DamianMorales1437/Automatizacion_y_Control/Diseño vru/Tabla Elementos.xlsx

LISTA DE MATERIALES INSTALADOS EN EL DOBLEFONDO Y GABINETE
ITEM | MARCA | REFERENCIA | DESCRIPCIÓN | CANT. | LINK
1 | ALLEN BRADLEY | 1769-L30ER | CONTROLADOR DUAL ETHERNET, MEMORIA 1Mb, EXPANDIBLE CON8 I/O, 16 NODOS ETHERNET IP | 1 | https://www.rockwellautomation.com/en-us/products/details.1769-L30ER.html
2 | ALLEN BRADLEY | 1769-PA2 | FUENTE DE ALIMENTACIÓN PARA COMPACT I/O A 120/240V CA, (5V @ 2 AMP) | 1 | https://www.rockwellautomation.com/en-us/products/details.1769-PA2.html
3 | ALLEN BRADLEY | 1769-IQ16 | MODULO DE ENTRADA DIGITAL DE16 CANALES 24VDC | 1 | https://www.rockwellautomation.com/en-us/products/details.1769-IQ16.html
4 | ALLEN BRADLEY | 1769-OB8 | MÓDULO DE SALIDA DIGITAL DE 8 CANALES 24V DC | 1 | https://www.rockwellautomation.com/en-us/products/details.1769-OB8.html
5 | ALLEN BRADLEY | 1769-IF16C | MÓDULO DE ENTRADA DE CORRIENTE ANALÓGICA DE ALTA DENSIDAD COMPACTA DE 16 CANALES | 1 | https://www.rockwellautomation.com/es-mx/products/details.1769-IF16C.html
6 | ALLEN BRADLEY | 1769-OF8C | MODULO DE SALIDAS DE CORRIENTE ANALOGICA DE ALTA TENSION COMPACTA DE 8 CANALES | 1 | https://www.rockwellautomation.com/es-mx/products/details.1769-OF8C.html
7 | ALLEN BRADLEY | 1769-ECR | TERMINADOR FINAL DERECHO PARA COMPACTLOGIX | 1 | https://www.rockwellautomation.com/en-us/products/details.1769-ECR.html
8 | ALLEN BRADLEY | 1606-XLE240E | FUENTE DE ALIMENTACIÓN 24-28V DC, 240 W, 120/240V AC | 1 | https://www.rockwellautomation.com/en-us/products/details.1606-XLE240E.html
9 | ALLEN BRADLEY | 4983-DS120-402 | 4983 SURGE AND FILTER PROTECTION 120V, 40kA | 1 | https://www.rockwellautomation.com/en-us/products/details.4983-DS120-402.html
10 | SCHNEIDER ELECTRIC | A9F74210 | INTERRUPTOR BIPOLAR DE 10A | 1 | https://www.se.com/co/es/download/document/A9F74210_REACH_DECLARATION/
11 | STEGO | 01220.0-00 | HIGRÓSTATO MECÁNICO MFR012, (CAMPO DE REGULACIÓN DE 35 A 95%) MECHANICAL HYGROSTAT MFR 012 | 1 | https://www.directindustry.es/prod/stego/product-14212-186929.html
12 | STEGO | 01140.0-00 | TERMOSTATO SERIE 011, 0°C TO +60°C, NORMALMENTE CERRADO 10 A at 250 VAC | 1 | https://es.farnell.com/stego/01140-0-00/termostato-0-60-c-n-c/dp/645849
13 | STEGO | 02540.3-11 | LÁMPARA DE ILUMINACIÓN TIPO LED PARA INSTALAR EN TECHO DEL GABINETE | 1 | https://es.farnell.com/stego/02540-3-11/enclosure-light-5w-240v-screw/dp/3223082?st=02540.3-11
14 | STEGO | 06000-0.00 | RESISTENCIA CALEFACTORA 240V, 60W, 184mm, 70mm, 60mm | 1 | https://es.farnell.com/stego/06000-0-00/calentador-120-240v-ac-dc-50w/dp/1870826?st=06000-0.00
15 | DEXSON | DXN10092 | CANALETA RANURADA DE 60x60mm (ANCHO x ALTO) | - | https://www.se.com/co/es/download/document/DXN10092_ROHS_DECLARATION/
16 | DEXSON | DXN10072 | CANALETA RANURADA DE 40x60mm (ANCHO x ALTO) | - | https://www.se.com/co/es/download/document/DXN10072_ROHS_DECLARATION/
17 | FANDIS | FC-003 | INTERRUPTOR PARA LÁMPARA INSTALADO EN PUERTA (-1NC + 1NO) | 1 | https://www.fandis.com/en/products/FC-003/Limit-switch-with-roller-
18 | ALLEN BRADLEY | 1492-J6 | BORNA DE PASO ESTANDAR (ENTRADA ACOMETIDA) | 4 | https://www.rockwellautomation.com/en-us/products/details.1492-J6-BL.html
19 | ALLEN BRADLEY | 1492-JG6 | BORNA DE TIERRA (ENTRADA ACOMETIDA) | 2 | https://www.rockwellautomation.com/en-us/products/details.1492-JG6.html
20 | SCHNEIDER ELECTRIC | A9F74216 | INTERRUPTOR BIPOLAR DE 16A | 1 | https://www.se.com/co/es/download/document/A9F74216_REACH_DECLARATION/
21 | ALLEN BRADLEY | 1492-JD3FB24 | BORNA DE 2 NIVELES (BORNA PORTAFUSIBLE + BORNA DE PASO) | 48 | https://www.rockwellautomation.com/en-us/products/details.1492-JD3FB24.html
22 | ALLEN BRADLEY | 1492-JDG3FB | BORNA DE 3 NIVELES (BORNA PORTAFUSIBLE + BORNA DE PASO + BORNA DE TIERRA) | 3 | https://www.rockwellautomation.com/en-us/products/details.1492-JDG3FB.html
23 | ALLEN BRADLEY | 1492-GM35 | PORTAROTULO MARCADOR DE GRUPO | 11 | https://www.rockwellautomation.com/en-us/products/details.1492-GM35.html
24 | ALLEN BRADLEY | 1492-ERL35 | FRENO PARA BORNAS Y COMPONENTES | 35 | https://www.rockwellautomation.com/en-us/products/details.1492-ERL35.html
25 | ALLEN BRADLEY | 1492-WFB424 | BORNA PORTAFUSIBLE CON LED DE FALLA | 4 | https://www.rockwellautomation.com/en-us/products/details.1492-WFB424.html
26 | ALLEN BRADLEY | 1492-WFB4250 | BORNA PORTAFUSIBLE CON NEÓN DE FALLA | 5 | https://www.rockwellautomation.com/en-us/products/details.1492-WFB4250.html
27 | ALLEN BRADLEY | 1492-J4 | BORNA DE PASDO ESTANDAR | 9 | https://www.rockwellautomation.com/en-us/products/details.1492-J4.html
28 | ALLEN BRADLEY | 1492-EBJD3FB | TAPA PARA BORNAS DE 2 NIVELES Y 3 NIVELES | 2 | https://www.rockwellautomation.com/en-us/products/details.1492-EBJD3FB.html
29 | ALLEN BRADLEY | 1492-EBJ3 | TAPA PARA BORNAS DE PASO ESTANDAR | 6 | https://www.rockwellautomation.com/en-us/products/details.1492-EBJ3.html
30 | MATRIMOL | T-25M | AISLADOR PARA BARRAS DE TIERRA Y RIELES DIN OMEGA | 15 | https://matrimol.com.co/producto/t-25m/
31 | N/A | N/A | BARRAS DE TIERRA | 2
32 | ALLEN BRADLEY | 199-DR2 | RIEL DIN OMEGA 35mm | 5 | https://www.rockwellautomation.com/en-us/products/details.199-DR2.html
33 | NACIONAL | N/A | POLICARBONATO TRANSPARENTE DE 3 mm DE ESPESOR | 2
33 |  |  |  | 1
34 |  |  |  | 1
