DamianMorales1437/Automatizacion_y_Control/(list of files, cad)

Other CAD files:
Diseño vru/Conexionado/5005.dwg
Diseño vru/Planos DWG/DI2.dwg
Diseño vru/PLCsv2.dwg
Diseño vru/Conexionado/5015.dwg
Diseño vru/Planos DWG/AI1.dwg
Diseño vru/Conexionado/5013.dwg
Diseño vru/Planos DWG/Tablero.dwg
Diseño vru/Conexionado/5010.dwg
Diseño vru/Planos DWG/DI1.dwg
Diseño vru/Conexionado/5014.dwg
Diseño vru/Planos DWG/TBDC_5005.dwg
Diseño vru/Conexionado/5007.dwg
Diseño vru/Planos DWG/AO.dwg
Diseño vru/Conexionado/5008.dwg
Diseño vru/Planos DWG/Alimentacion120VAC_5004.dwg
Diseño vru/Conexionado/5012.dwg
Diseño vru/Planos DWG/DO.dwg
Diseño vru/Conexionado/5006.dwg
Diseño vru/Planos DWG/Alimentación230VAC_5003.dwg
Diseño vru/Conexionado/5016.dwg
Diseño vru/Planos DWG/AI2.dwg
Diseño vru/Conexionado/5004.dwg
Diseño vru/Conexionado/5003.dwg
Diseño vru/Conexionado/5011.dwg
Diseño vru/Conexionado/5017.dwg
Diseño vru/Conexionado/5009.dwg
