DamianMorales1437/Automatizacion_y_Control/Diseño vru/wiringdetail.xlsx

TB-1 Discrete In | Instrument Tag | Termination Point | Notes
DI #00 | LS-0108 | D-0101 Gas suction scrubber pressure switch high | 0-24 vdc signals
DI #01 | LC-0109 | D-0101 Gas suction scrubber pressure switch low | 0-24 vdc signals
DI #02 | XS-0102 | LTP-0102 run status signal | 0-24 vdc signals | conexión | ps | plc | di | do | ai
DI #03 | XA-0102 | LTP-0102 overload alarm | 0-24 vdc signals | referencia | 1606-XLE240E | 1769-L30ER | 1769-IQ16 | 1769-OB8 | 1769-IF4
DI #04 | XS-0104 | E-0104 cooler fan status signal | 0-24 vdc signals
DI #05 | XA-0104 | E-0104 cooler fan overload alarm | 0-24 vdc signals
DI #06 | XS-0103 | K-0103 gas compressor run status signal | 0-24 vdc signals
DI #07 | XA-0103 | K-0103 gas compressor overload alarm | 0-24 vdc signals
DI #08 | XST-0103 | k-0103 gas compressor fail to start | 0-24 vdc signals
DI #09 | XSP-0103 | k-0103 gas compressor fail to stop | 0-24 vdc signals
DI #10 | spare
DI #11 | spare
DI #12 | spare
DI #13 | spare
DI #14 | spare
DI #15 | spare
DI #16
TB-2 Discrete Out | Instrument Tag | Termination Point | Notes
DO #00 | LY-0109 | LTP motor start/stop signal | salida del plc que enciende bomba
DO #01 | XY-0122 | cooler fan motor start/stop signal | salida del plc que enciende fan
DO #02 | XY-0115 | gas compressor motor start/stop signal | salida del plc para VSD encienda motor
DO #03 | XY-0102 | solenoid valve open/close signal | salida del plc para activar valvula de control
TB-3 Analog In | Instrument Tag | Termination Point | Notes
AI #00 | PT-0107 | D-0101 Gas suction scrubber pressure transmitter | 4-20 mA signals
AI #01 | PT-0105 | Gas compressor discharge pressure | 4-20 mA signals
AI #02 | TT-0103 | Gas compressor discharge temperature | 4-20 mA signals
DO #03 | XY-0102 | solenoid valve open/close signal | salida del plc para activar valvula de control
DO #04
DO #05
DO #06
DO #07
DO #08
DO #09
DO #10
DO #11
DO #12
DO #13
DO #14
DO #15
TB-3 Analog In | Instrument Tag | Termination Point | Notes
AI #00 | PT-0107 | D-0101 Gas suction scrubber pressure transmitter | 4-20 mA signals
AI #01 | PT-0105 | Gas compressor discharge pressure | 4-20 mA signals
AI #02 | TT-0103 | Gas compressor discharge temperature | 4-20 mA signals
AI #03
AI #04
AI #05
AI #06
AI #07
AI #08
AI #09
AI #10
AI #11
AI #12
AI #13
AI #14
AI #15
