DamianMorales1437/Automatizacion_y_Control/Diseño vru/2180389 _L1A.pdf

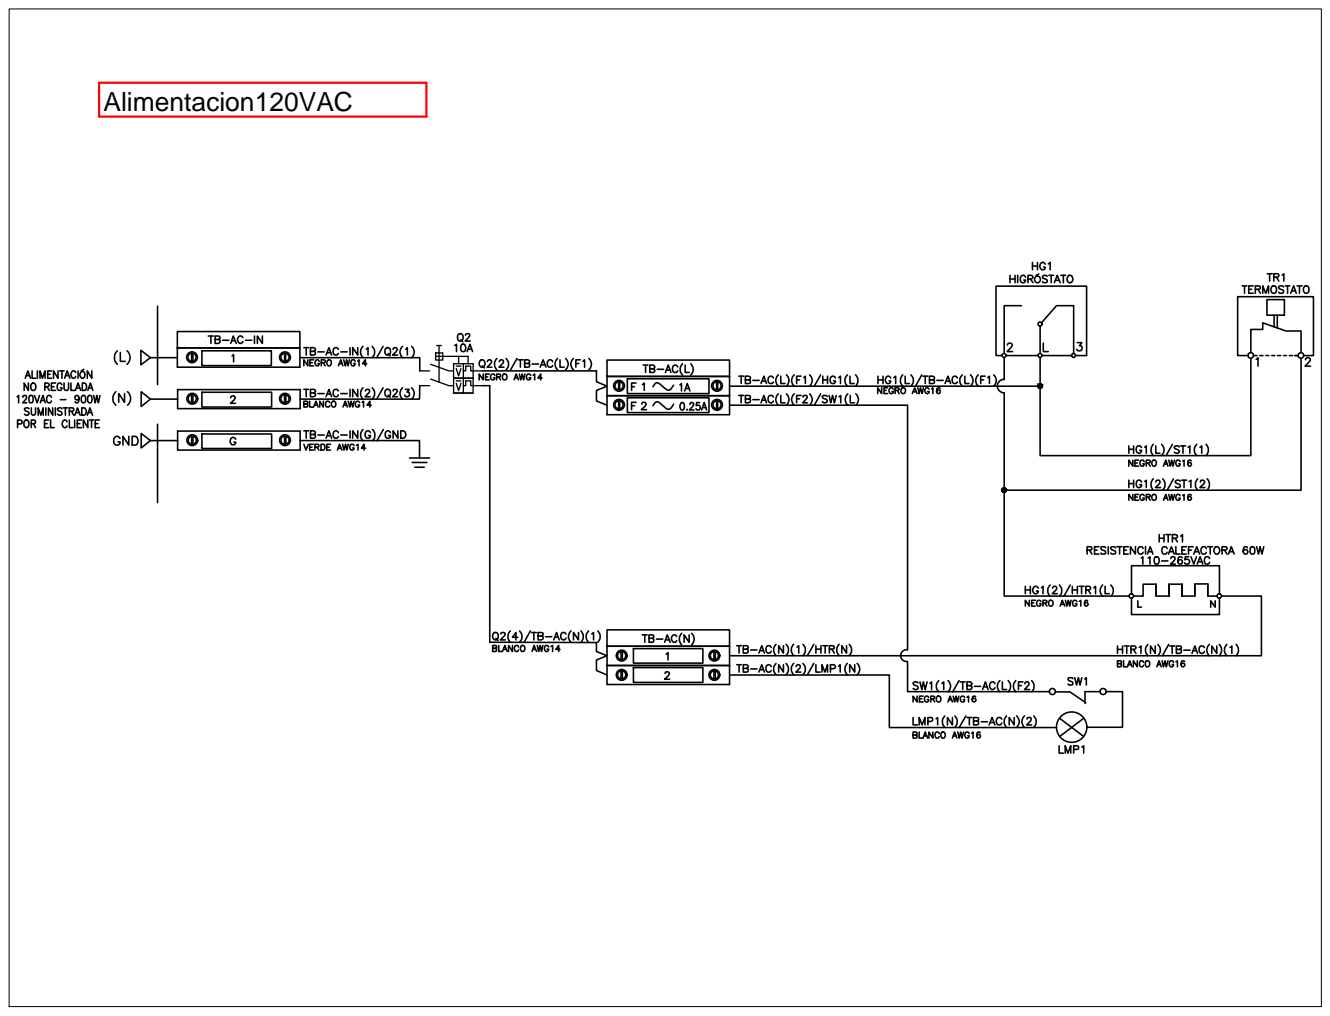
[picture p4: page 5]
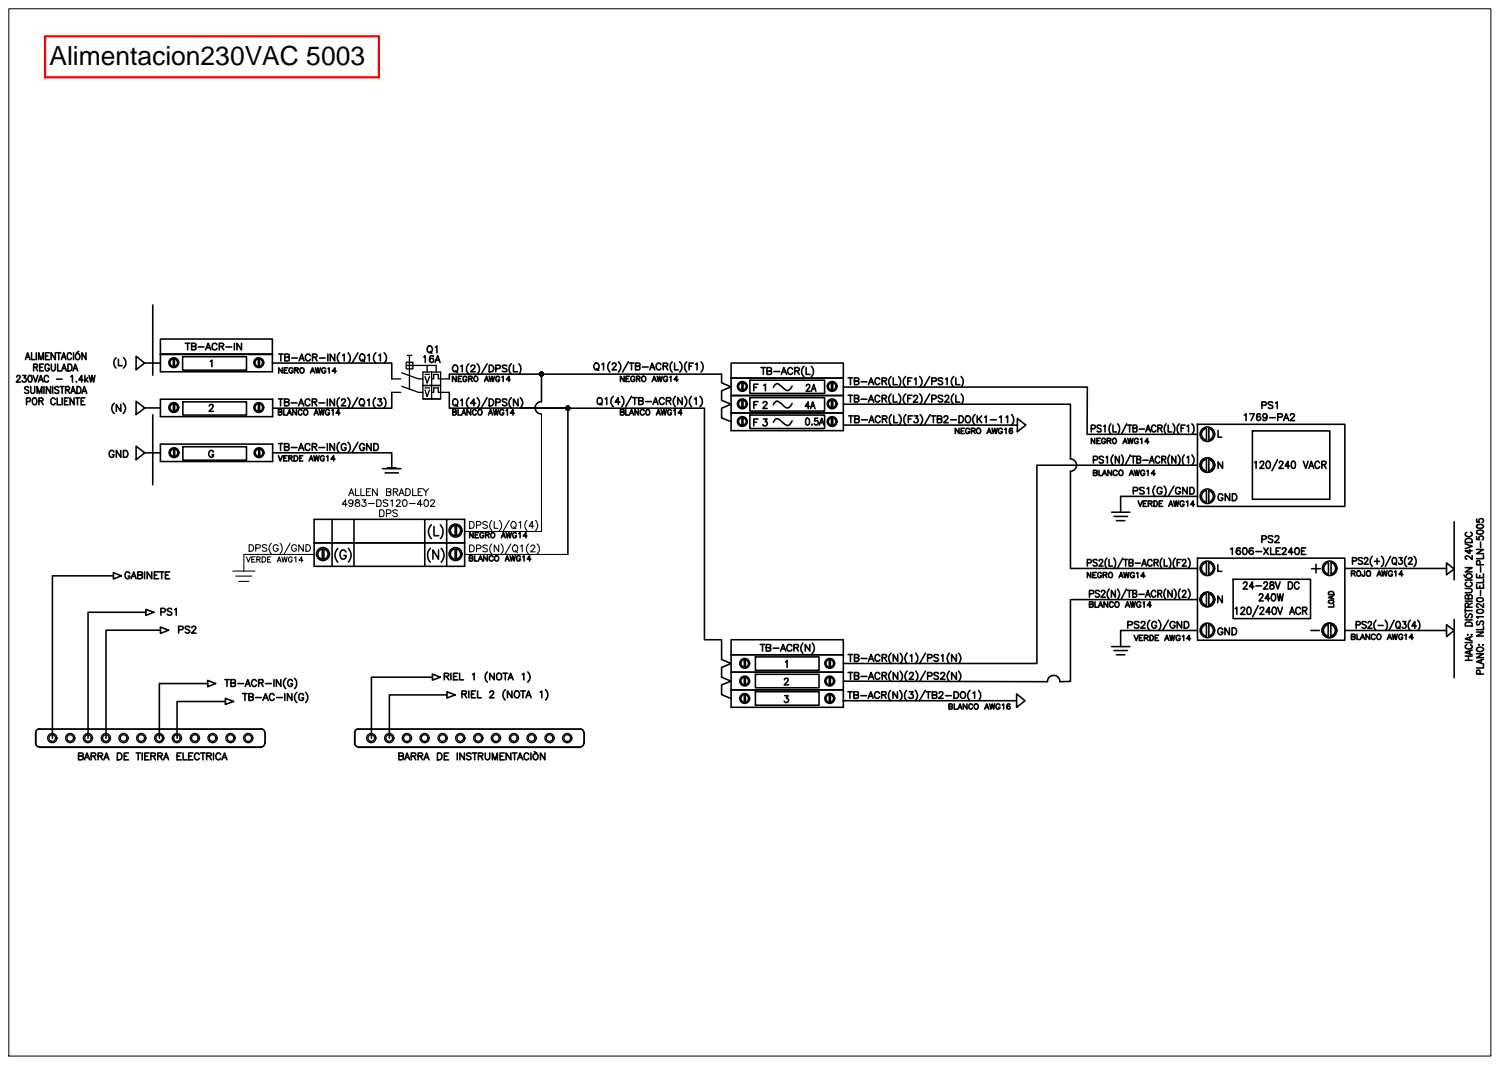
[picture p5: page 6]
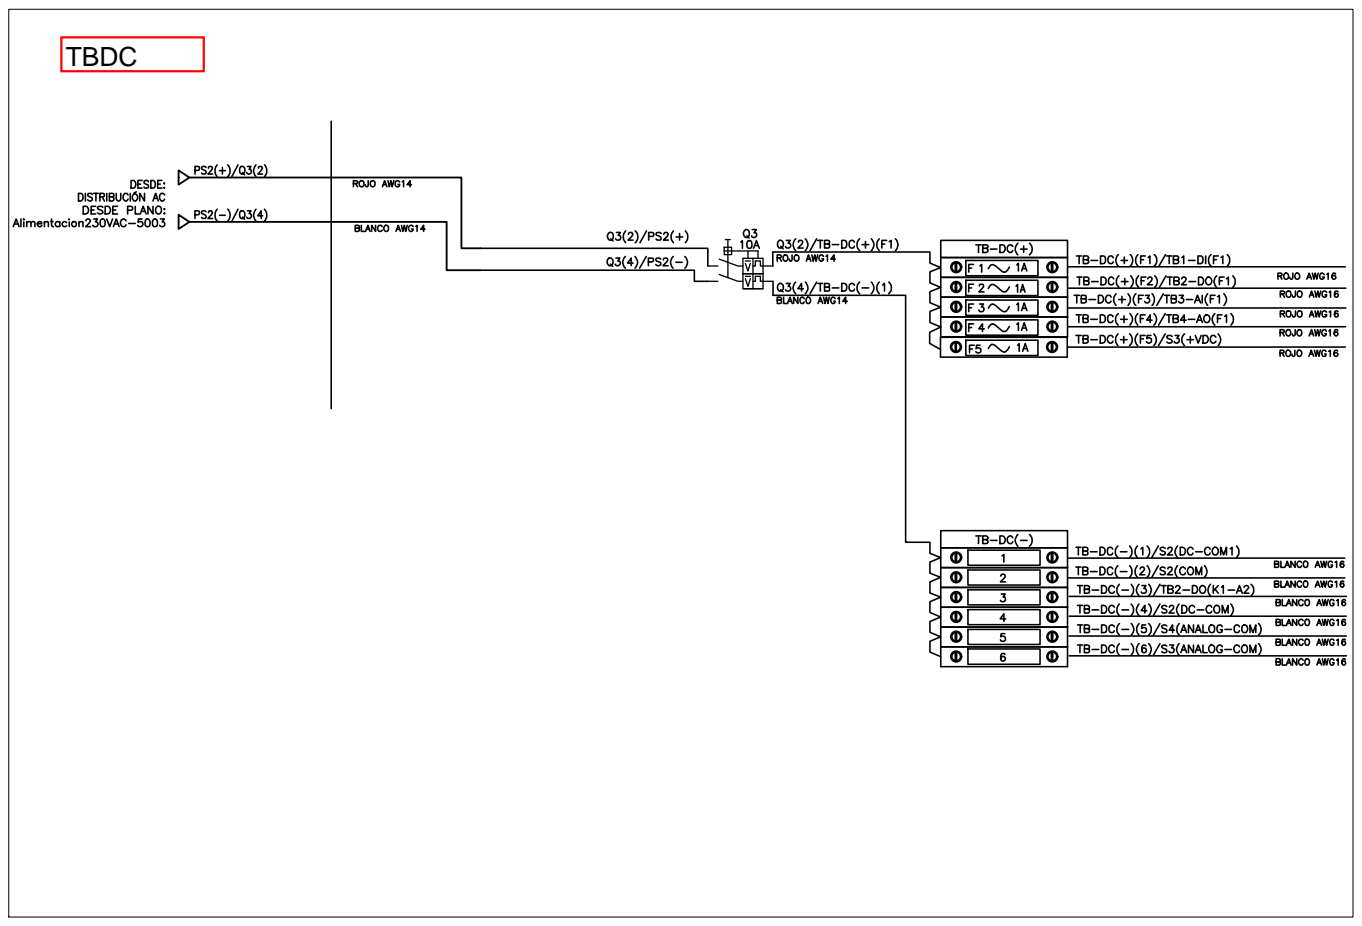
[picture p6: page 7]
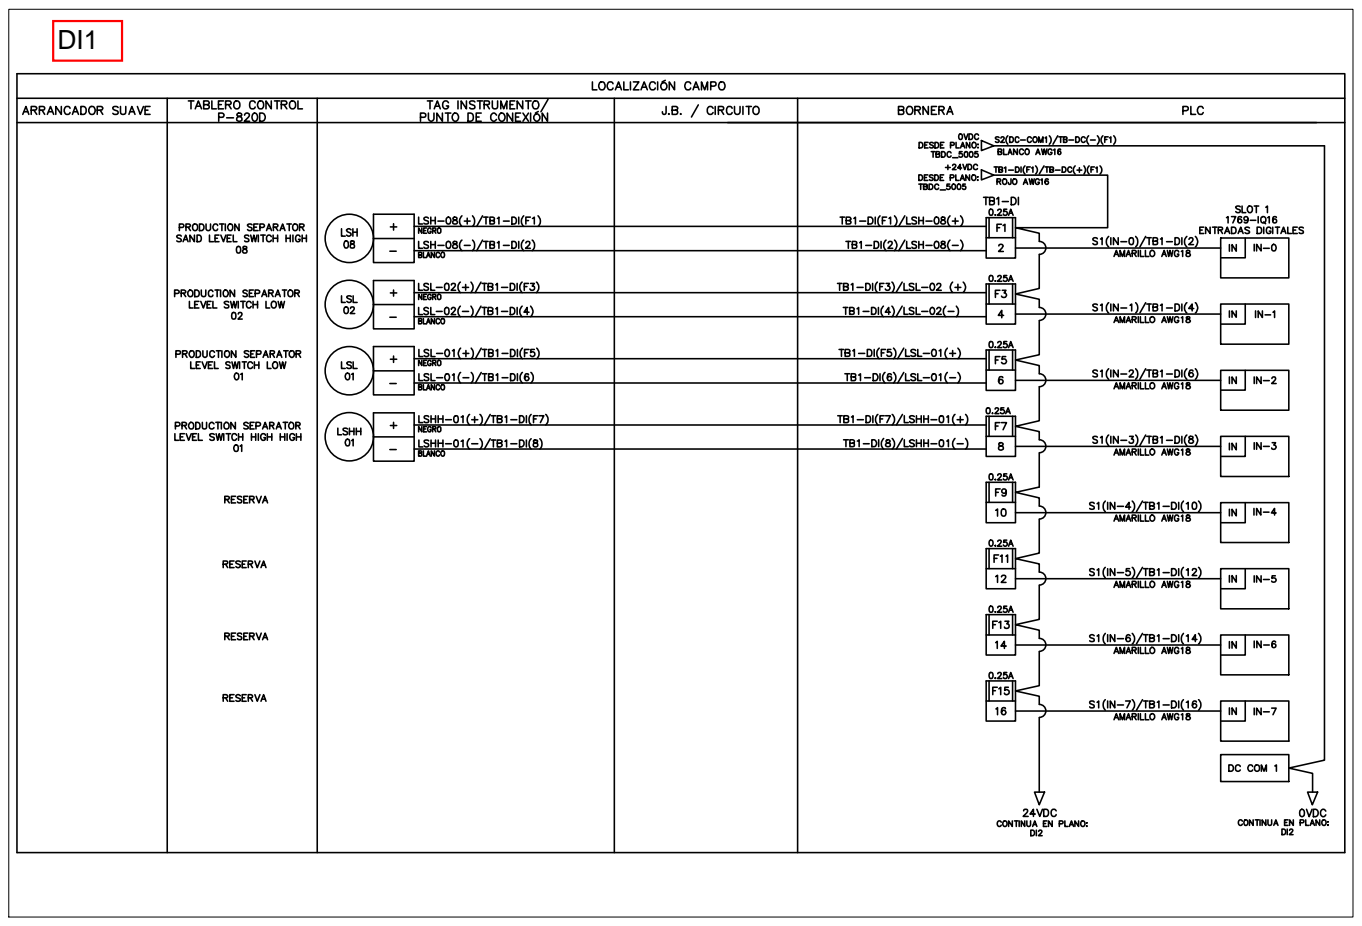
[picture p7: page 8]
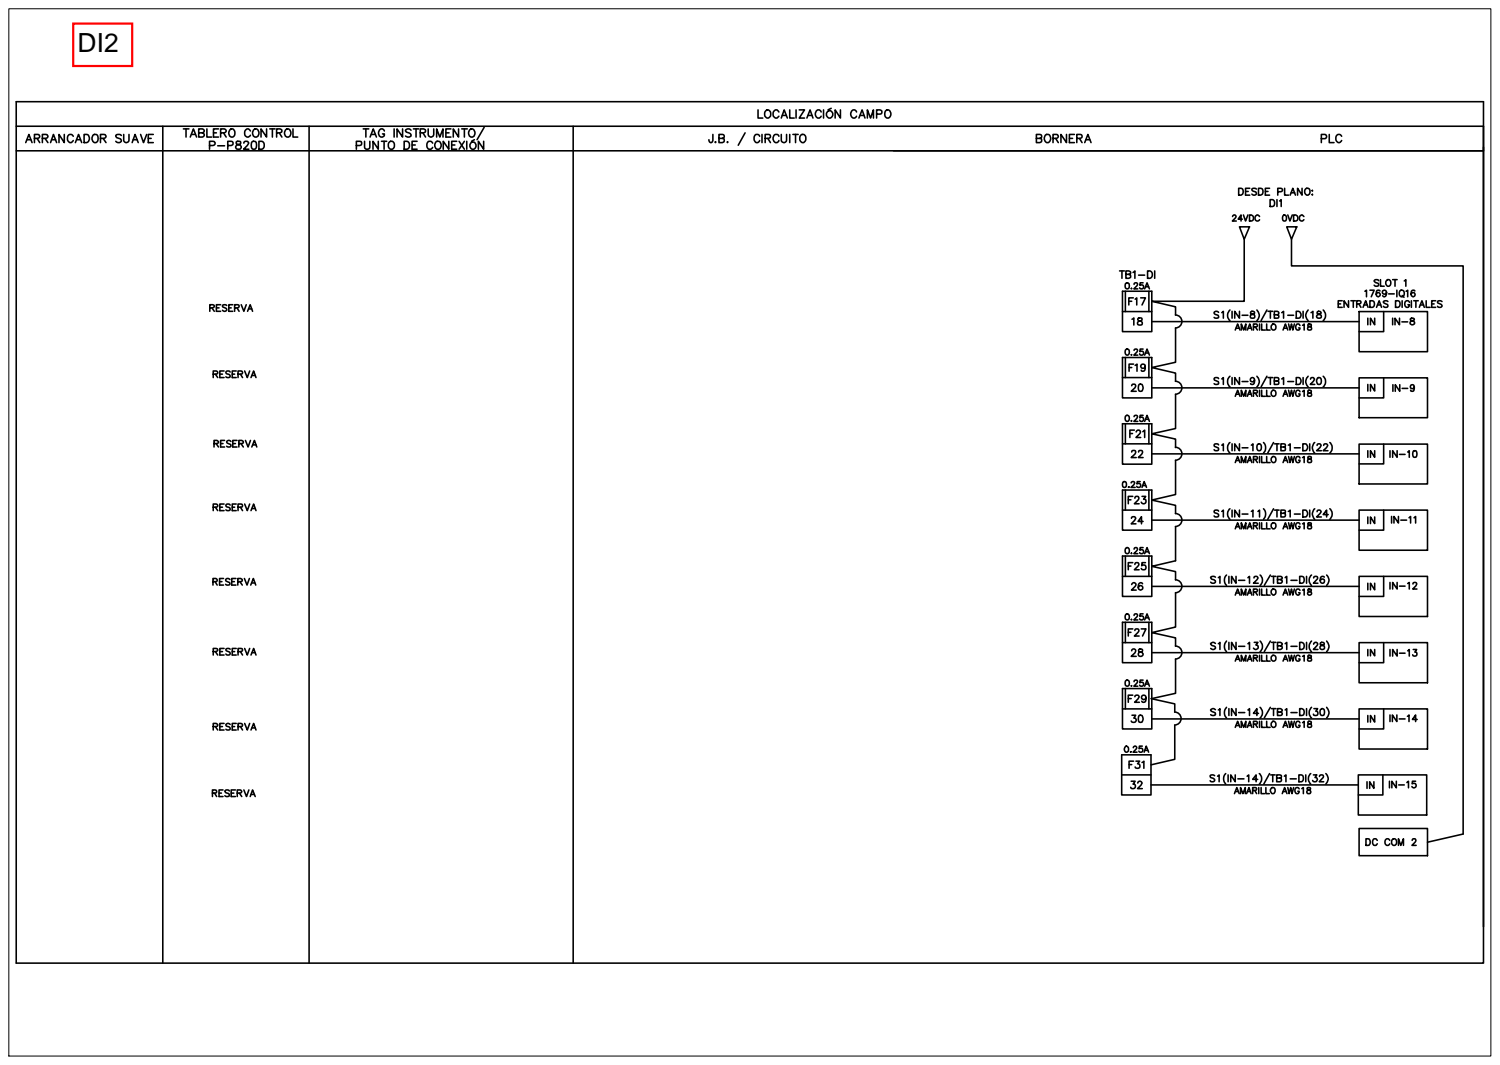
[picture p8: page 9]
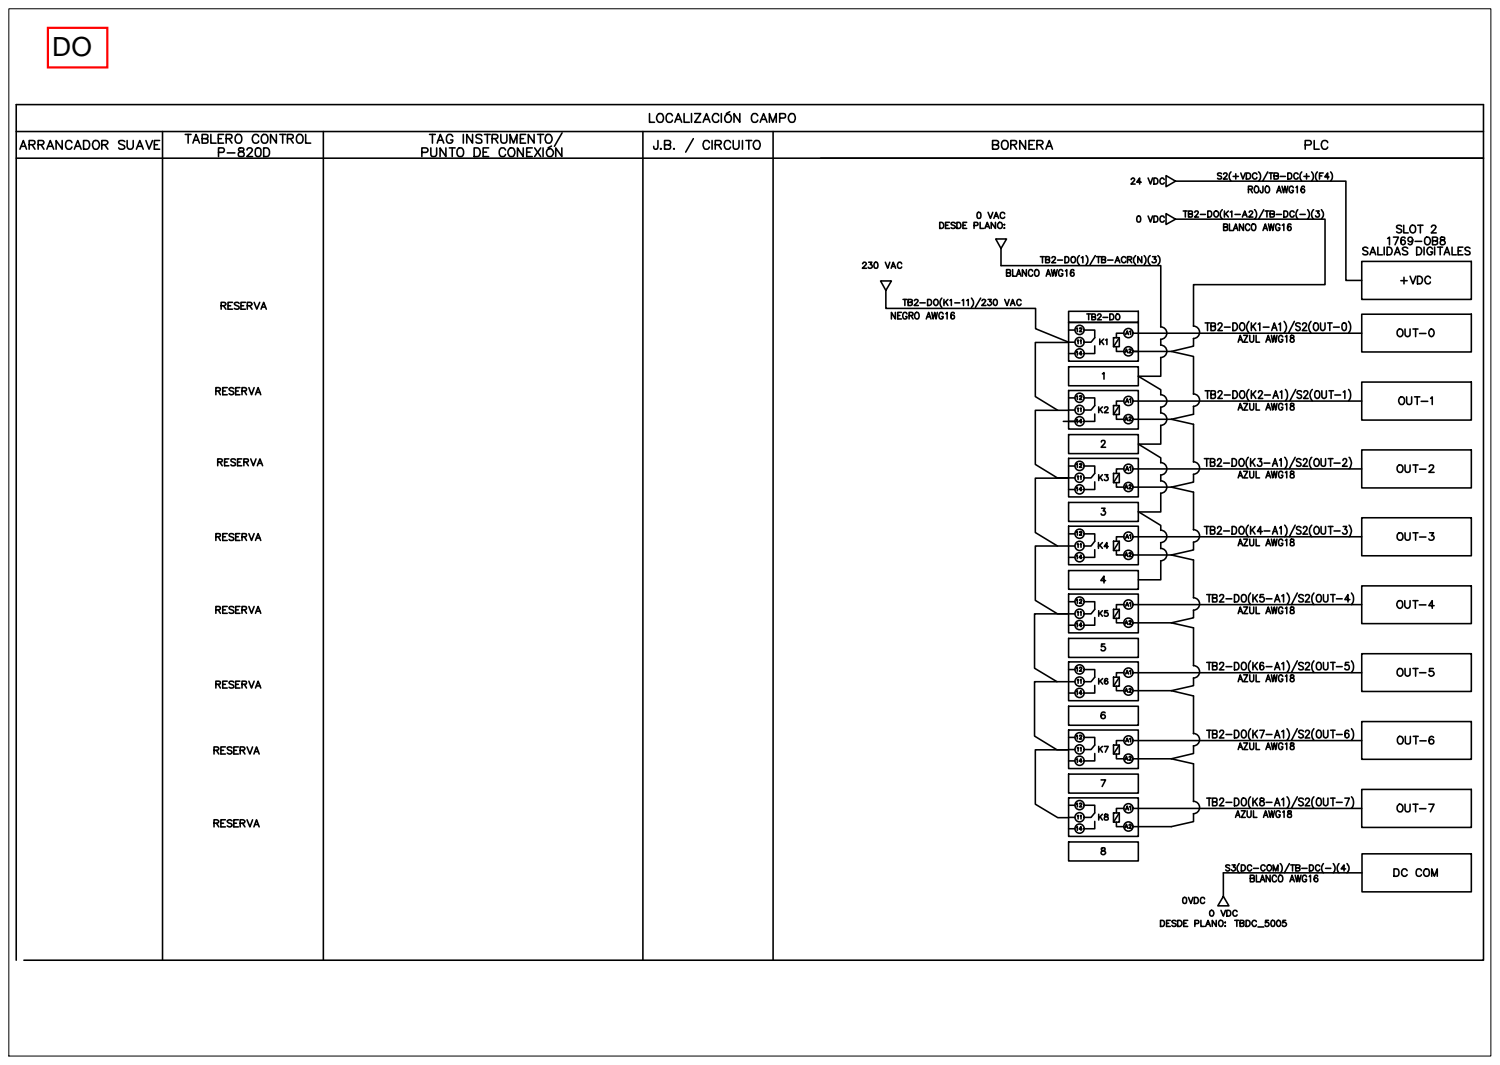
[picture p9: page 10]
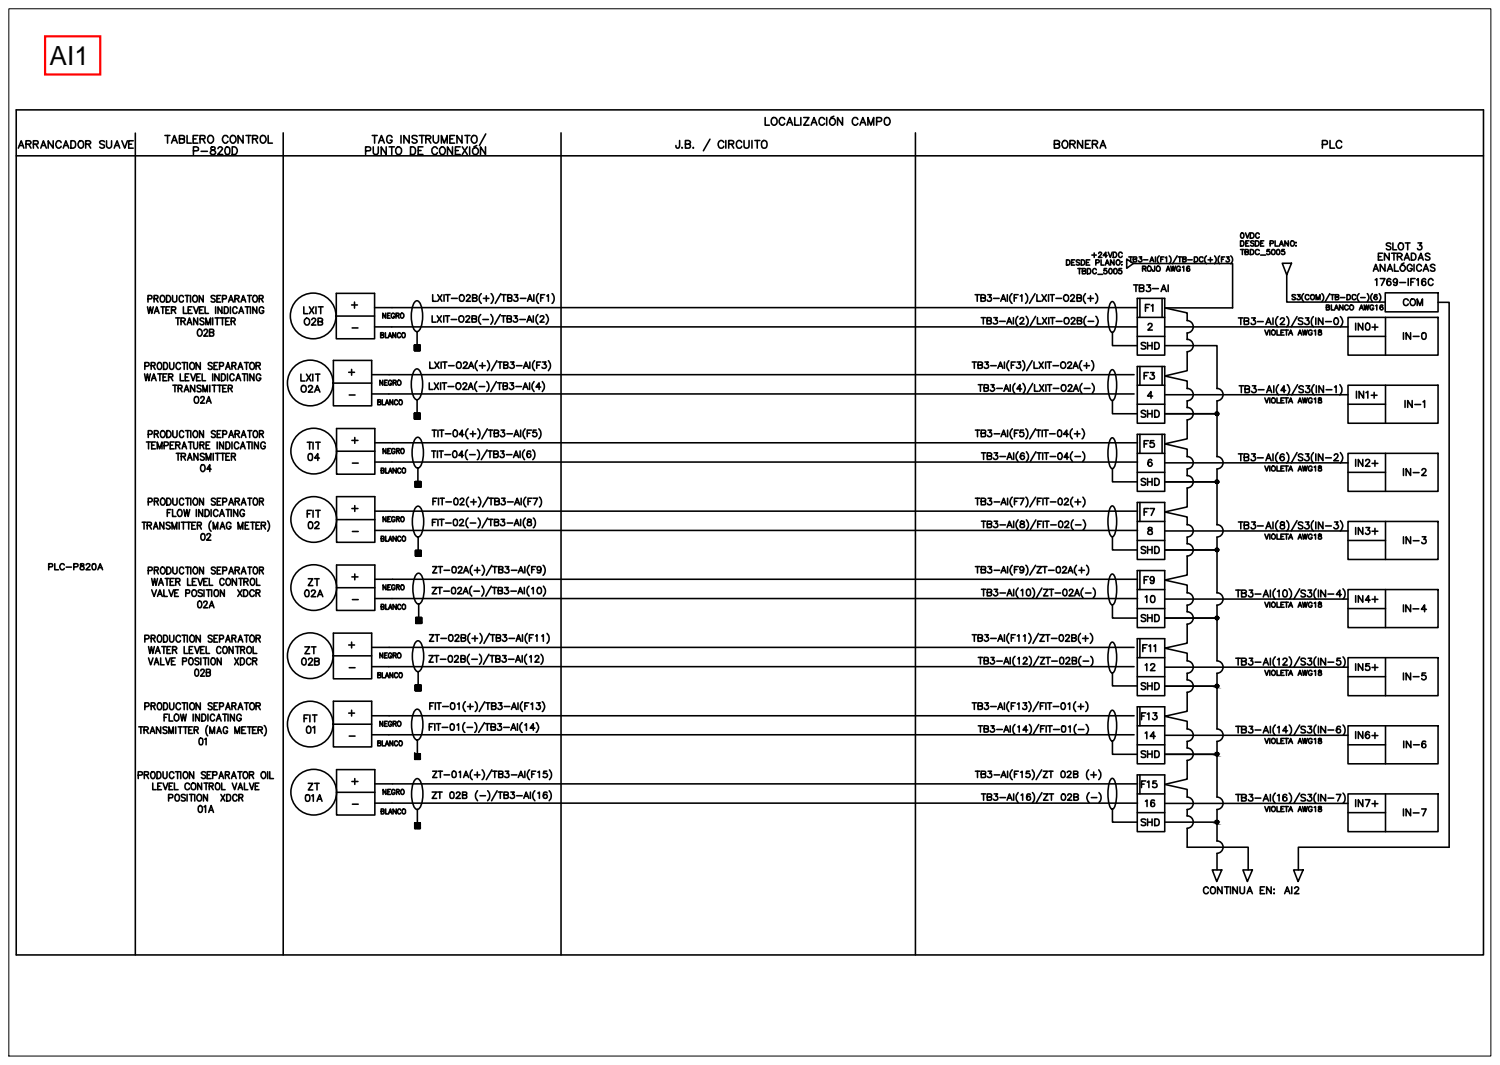
[picture p10: page 11]
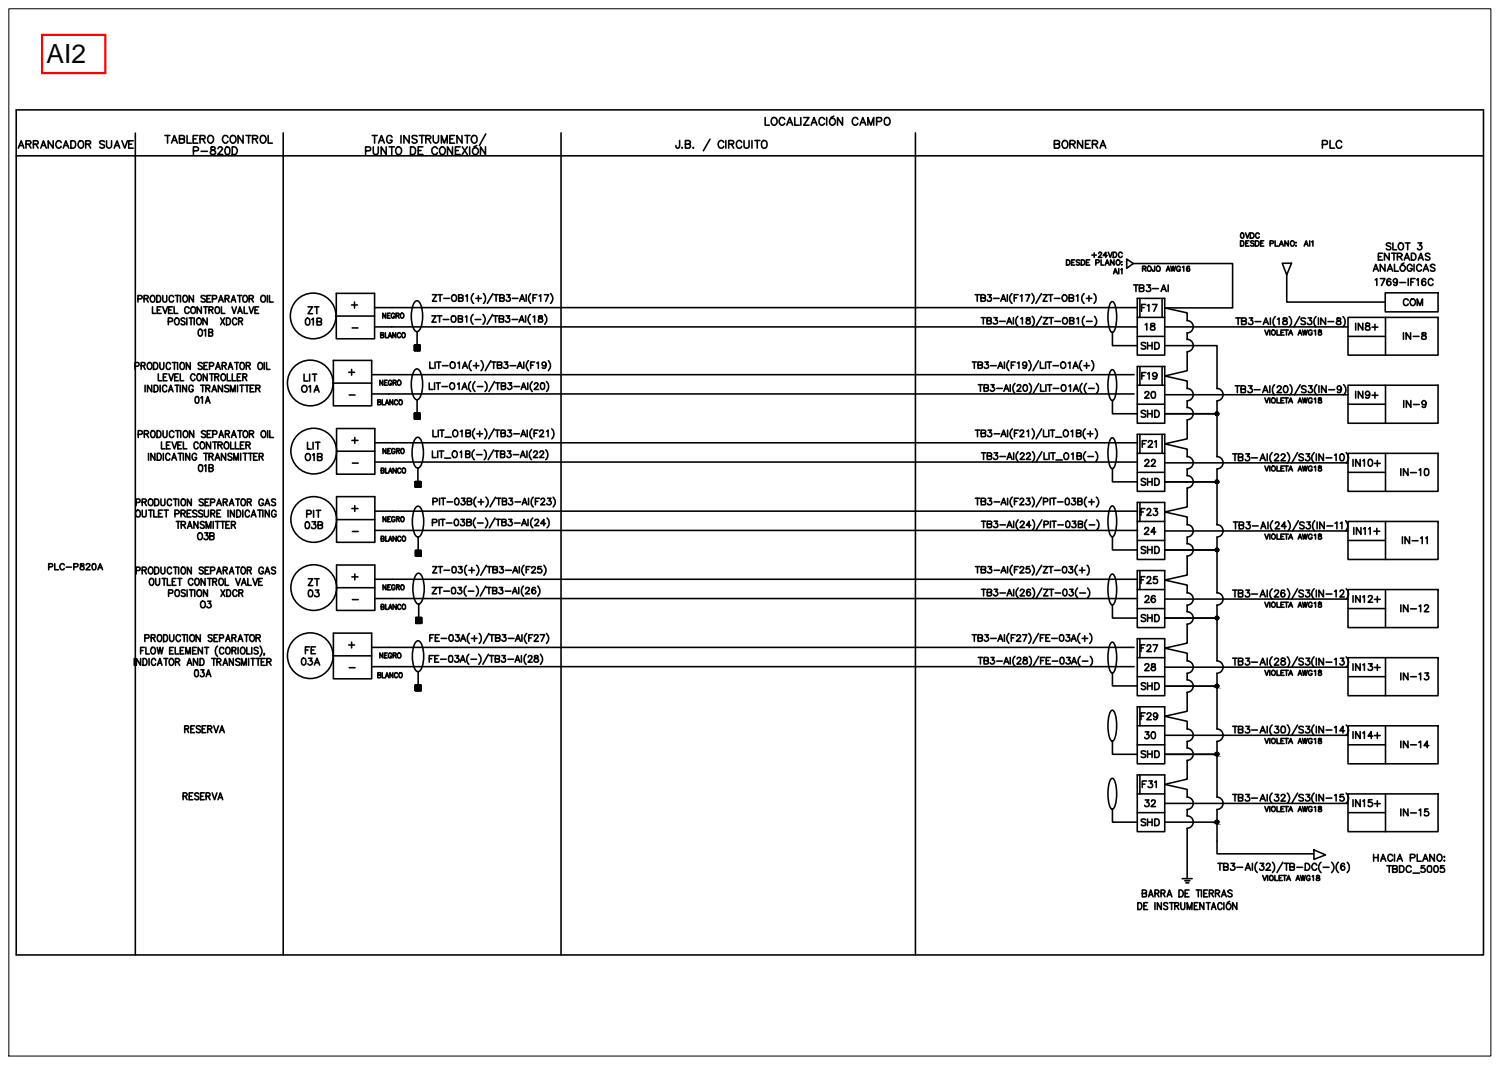
[picture p11: page 12]
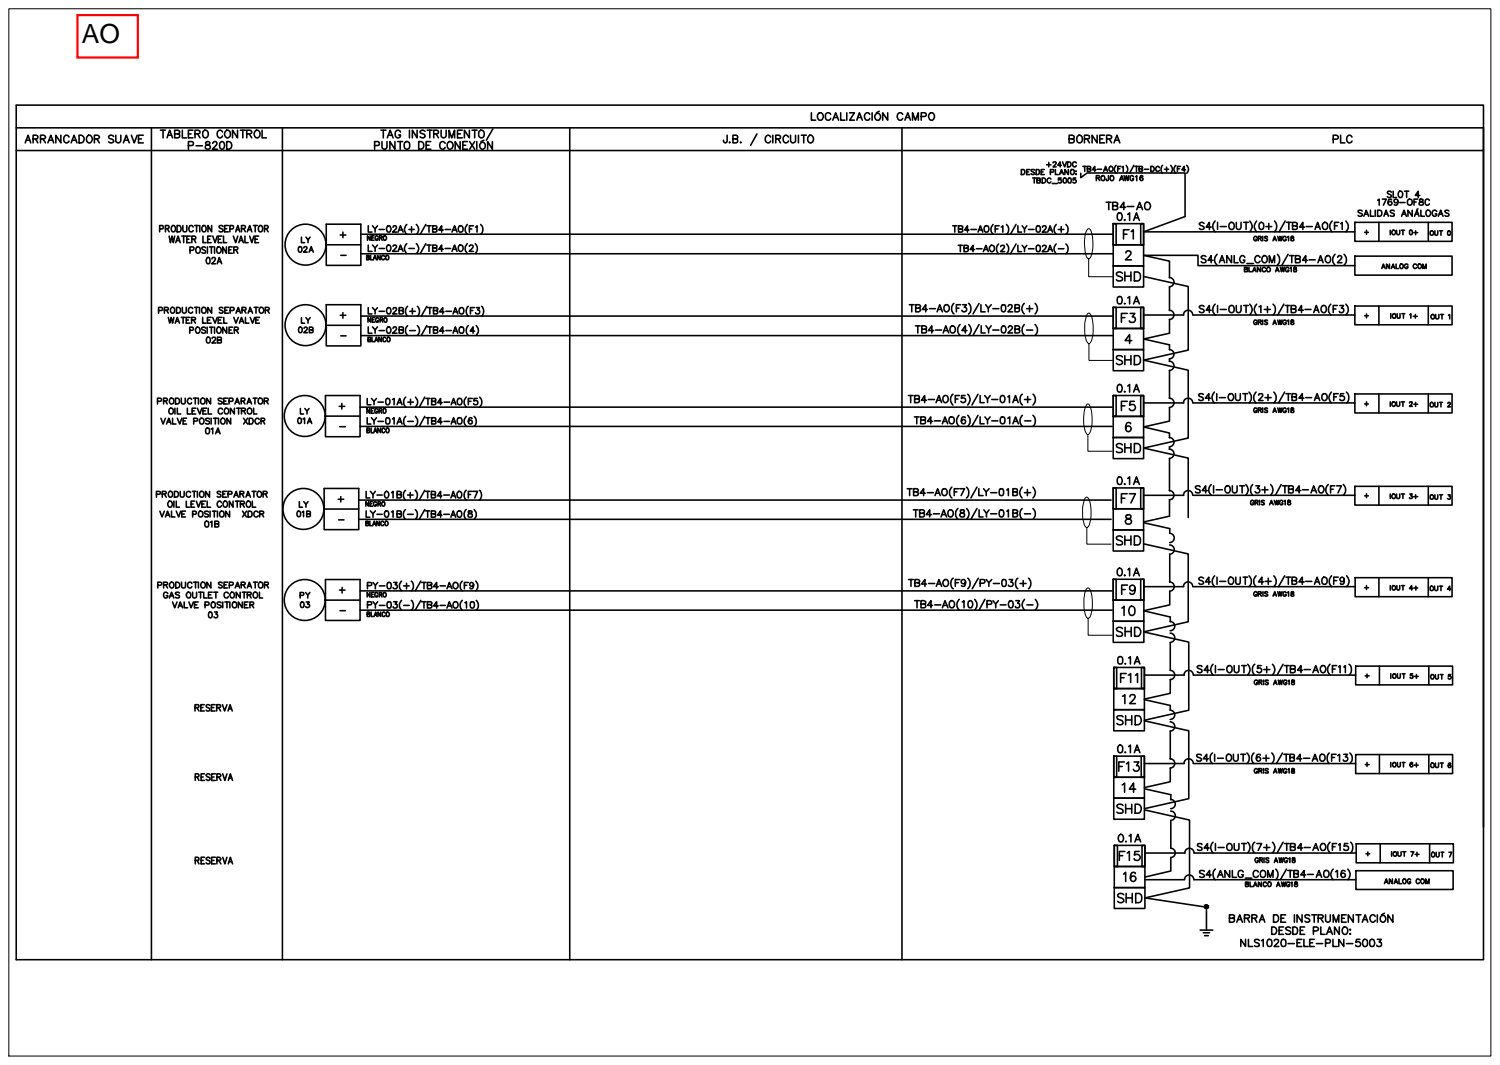
[picture p12: page 13]
