DamianMorales1437/Automatizacion_y_Control/Diseño vru/RIOTYPEB (1).pdf

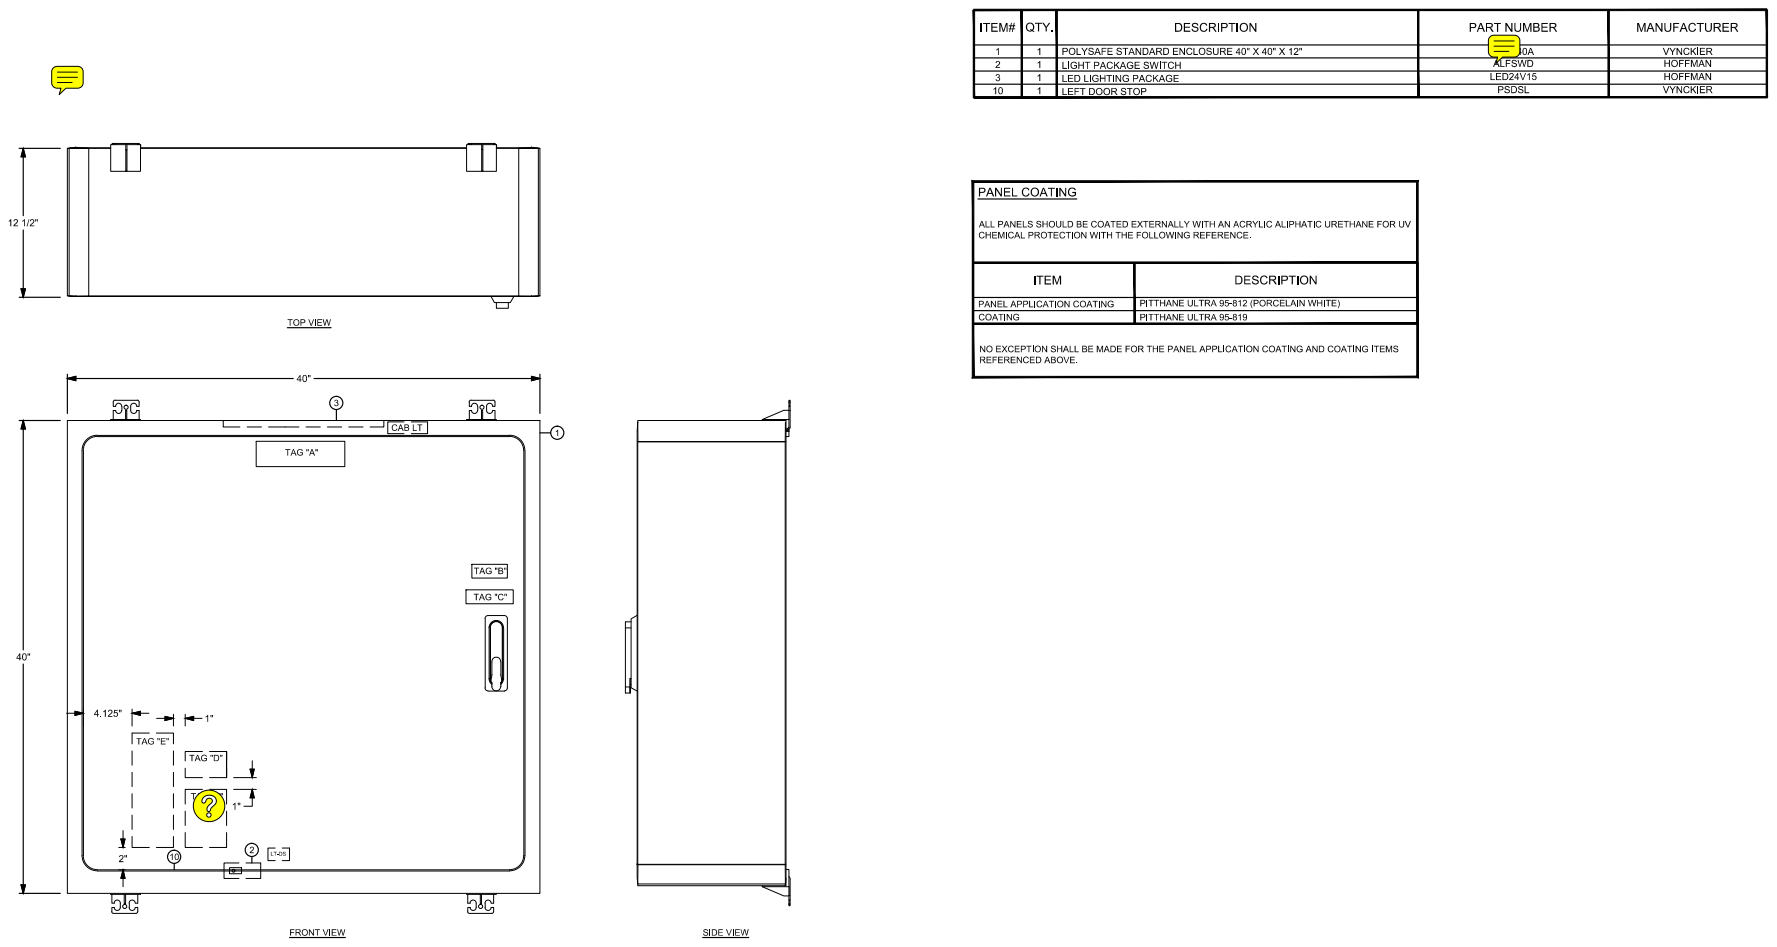
[picture p13: page 1]
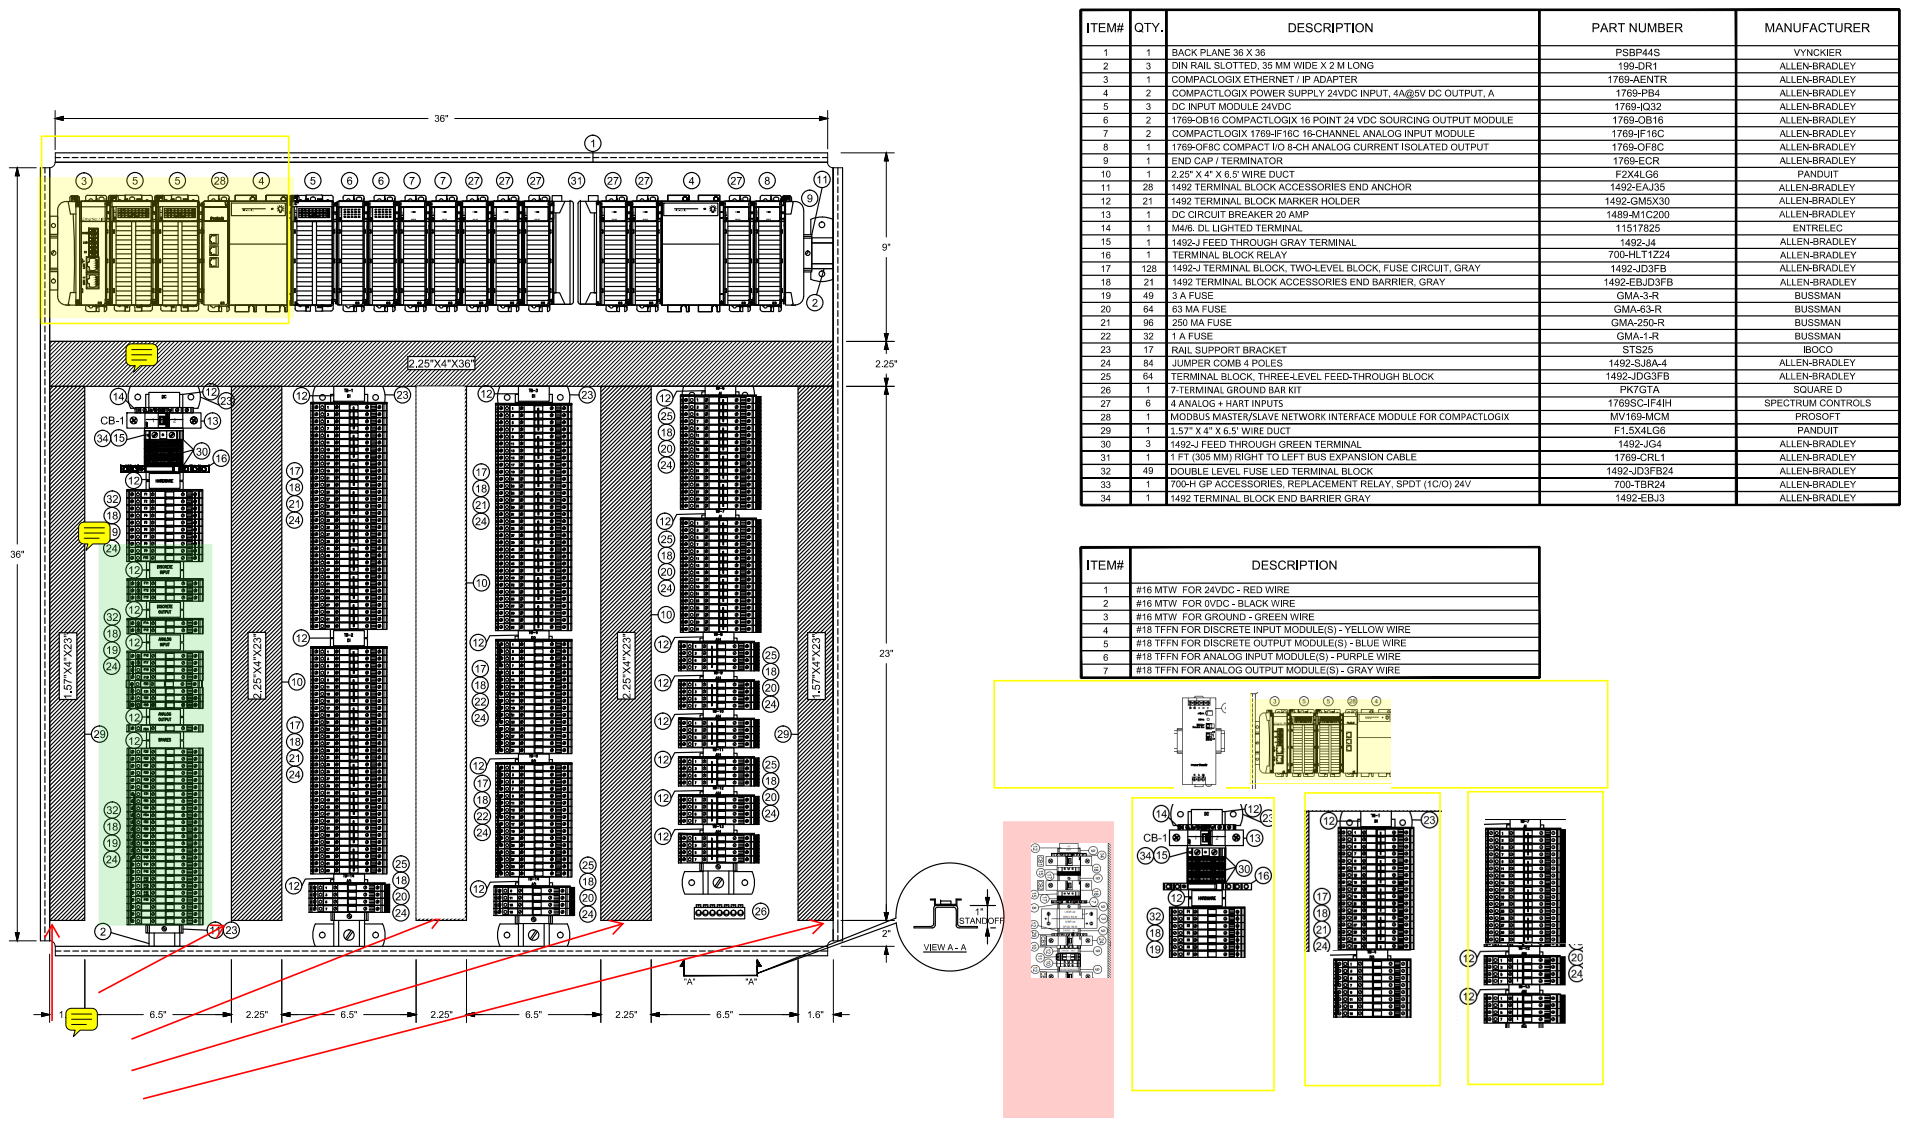
[picture p14: page 2]
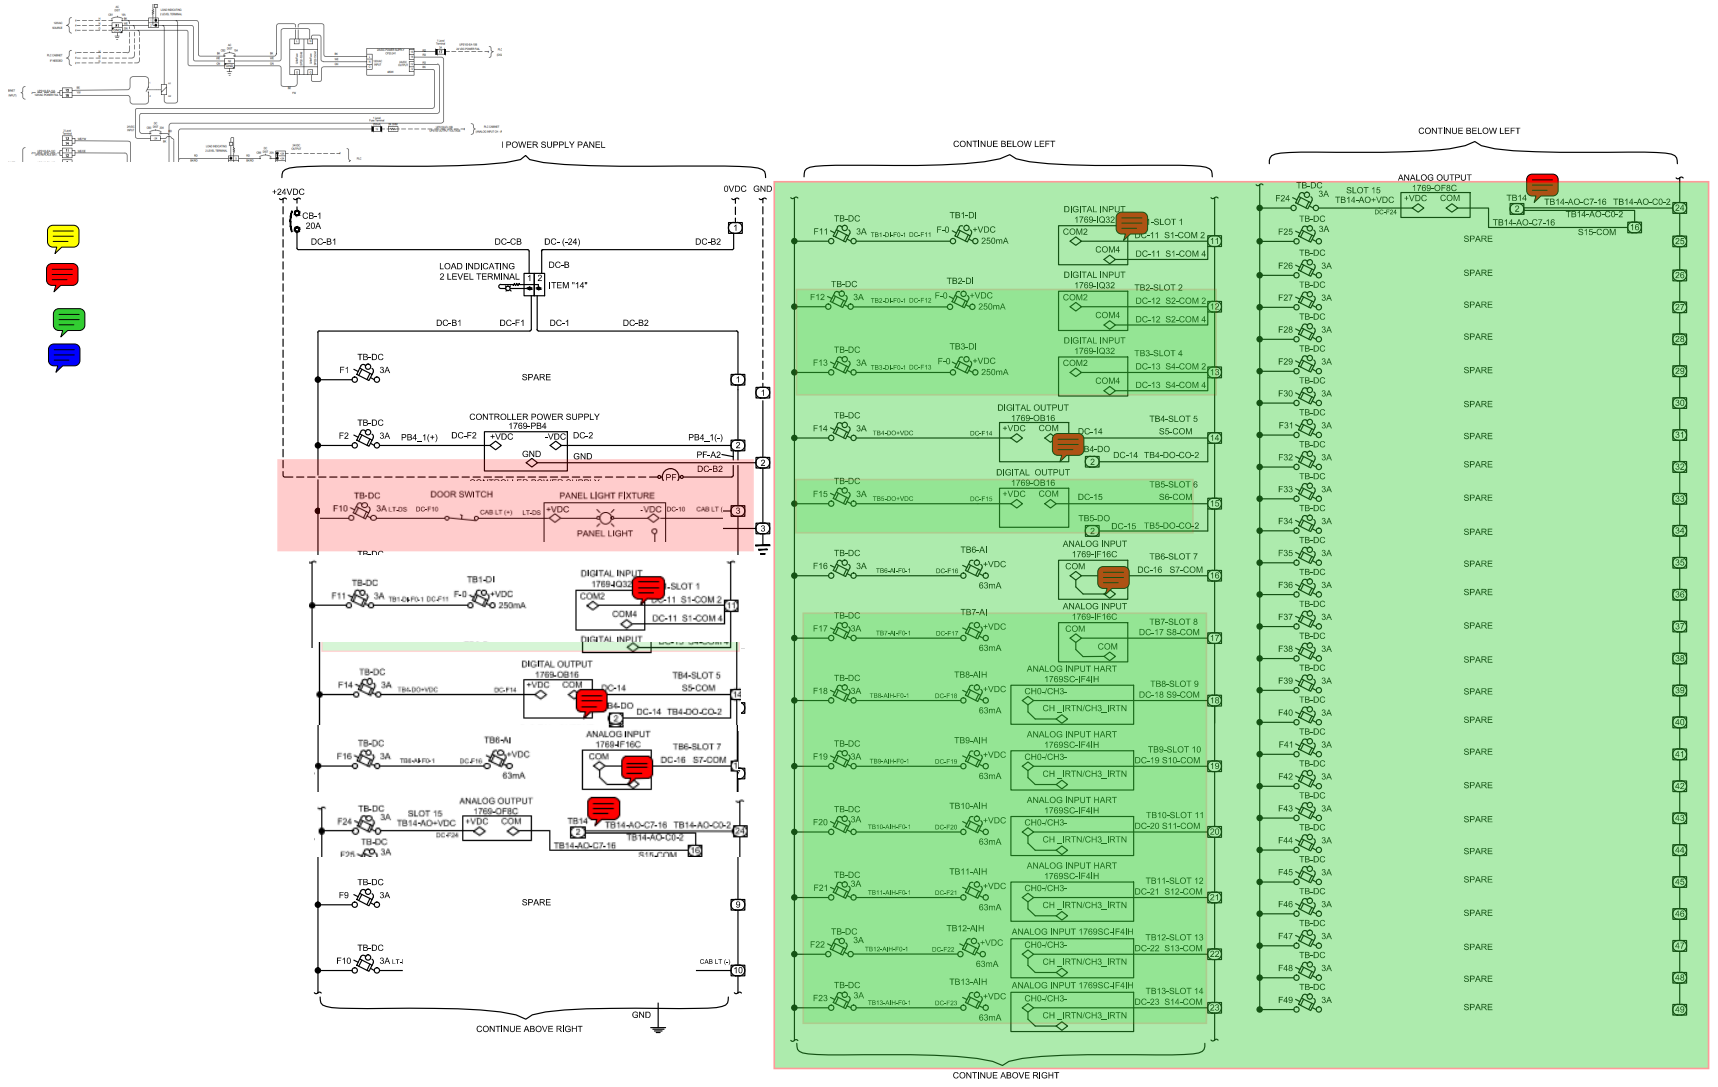
[picture p15: page 3]
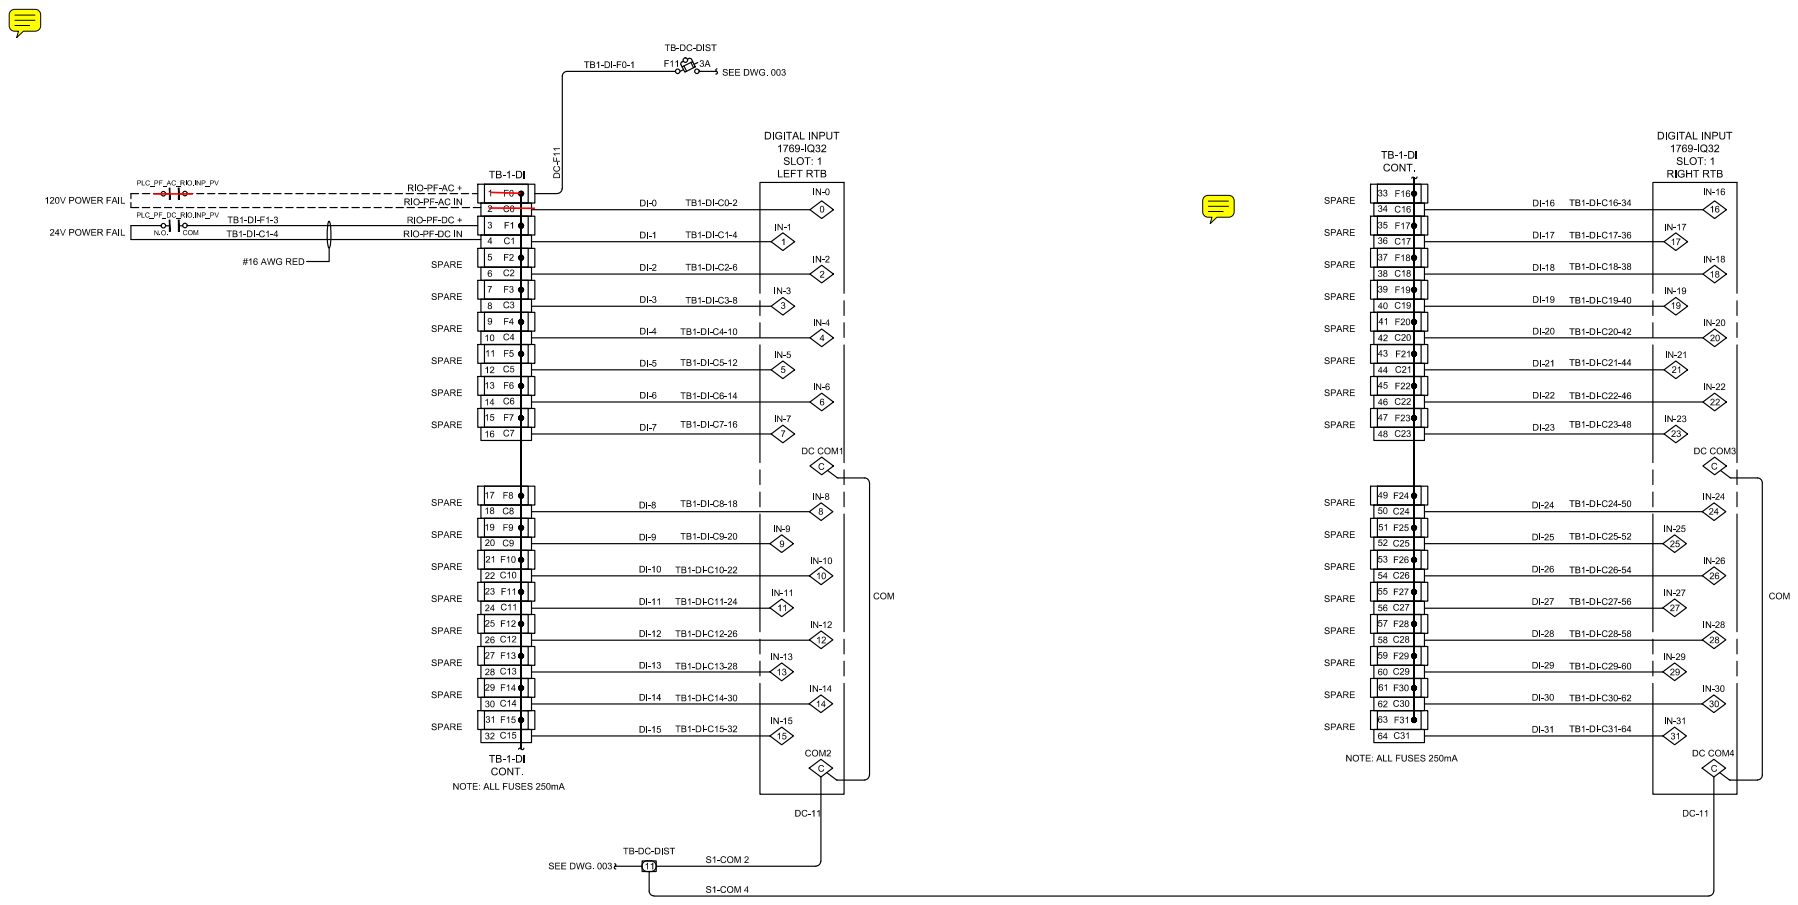
[picture p16: page 4]
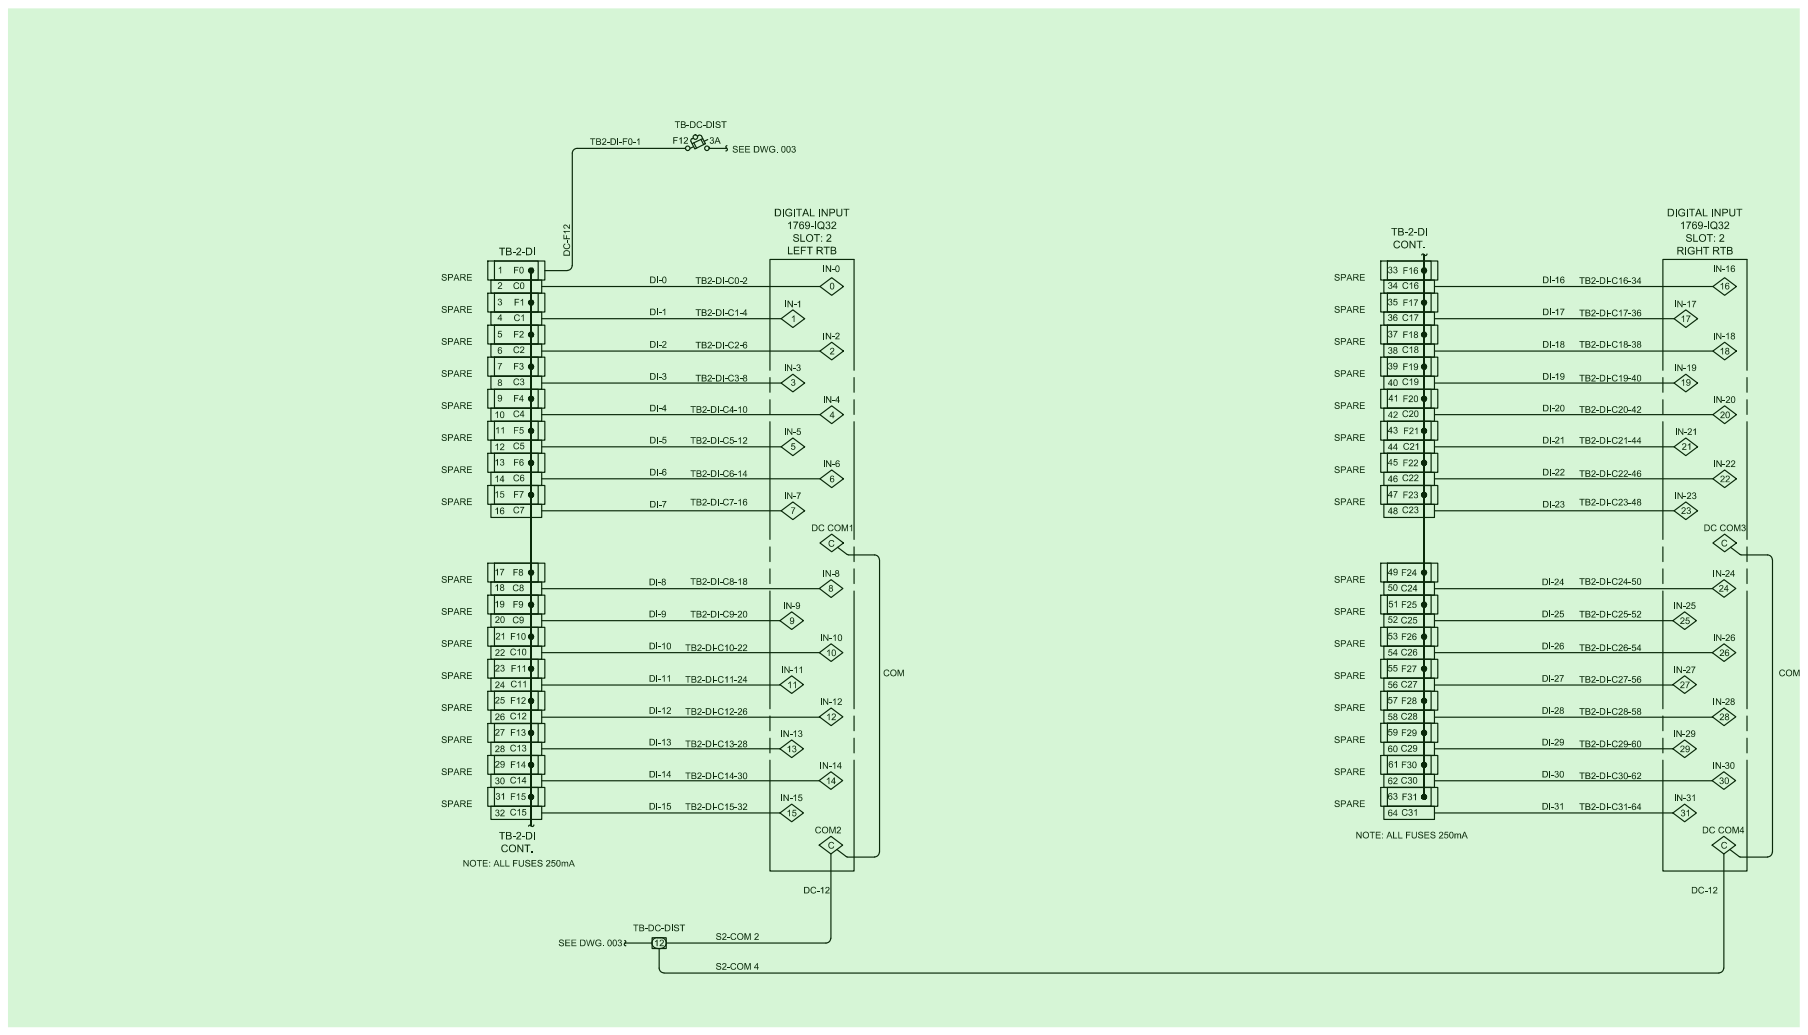
[picture p17: page 5]
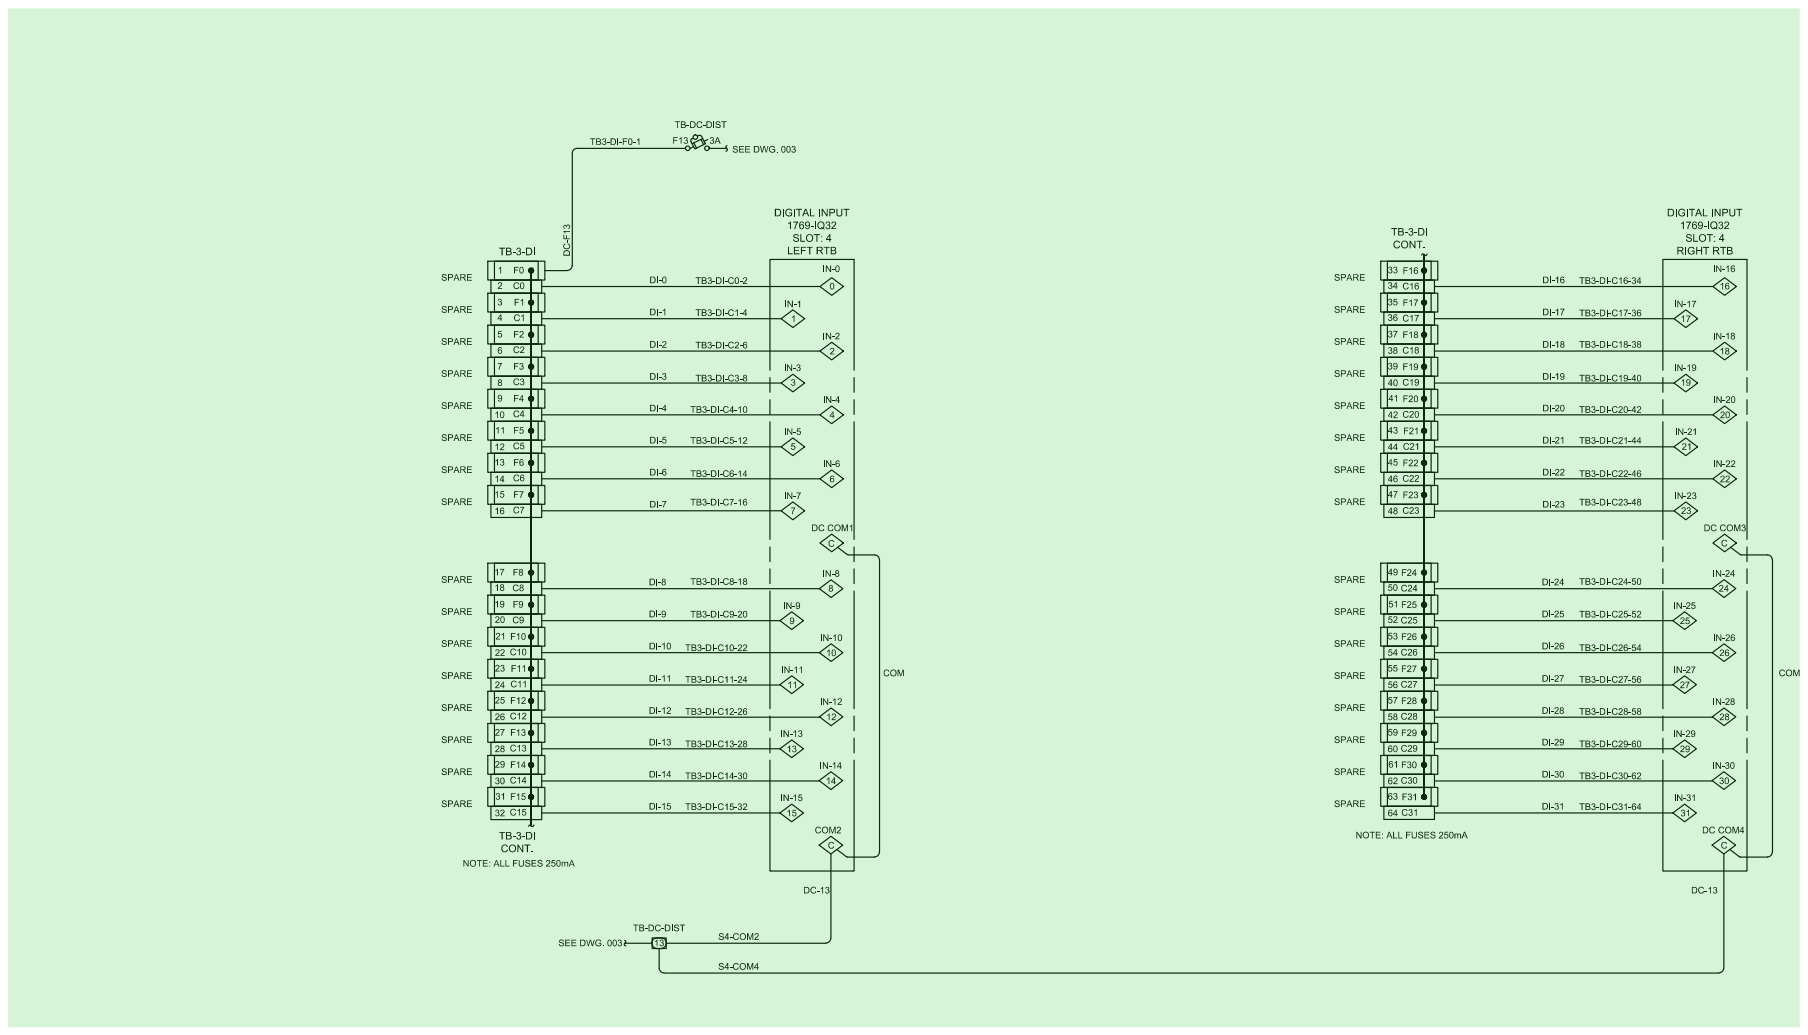
[picture p18: page 6]
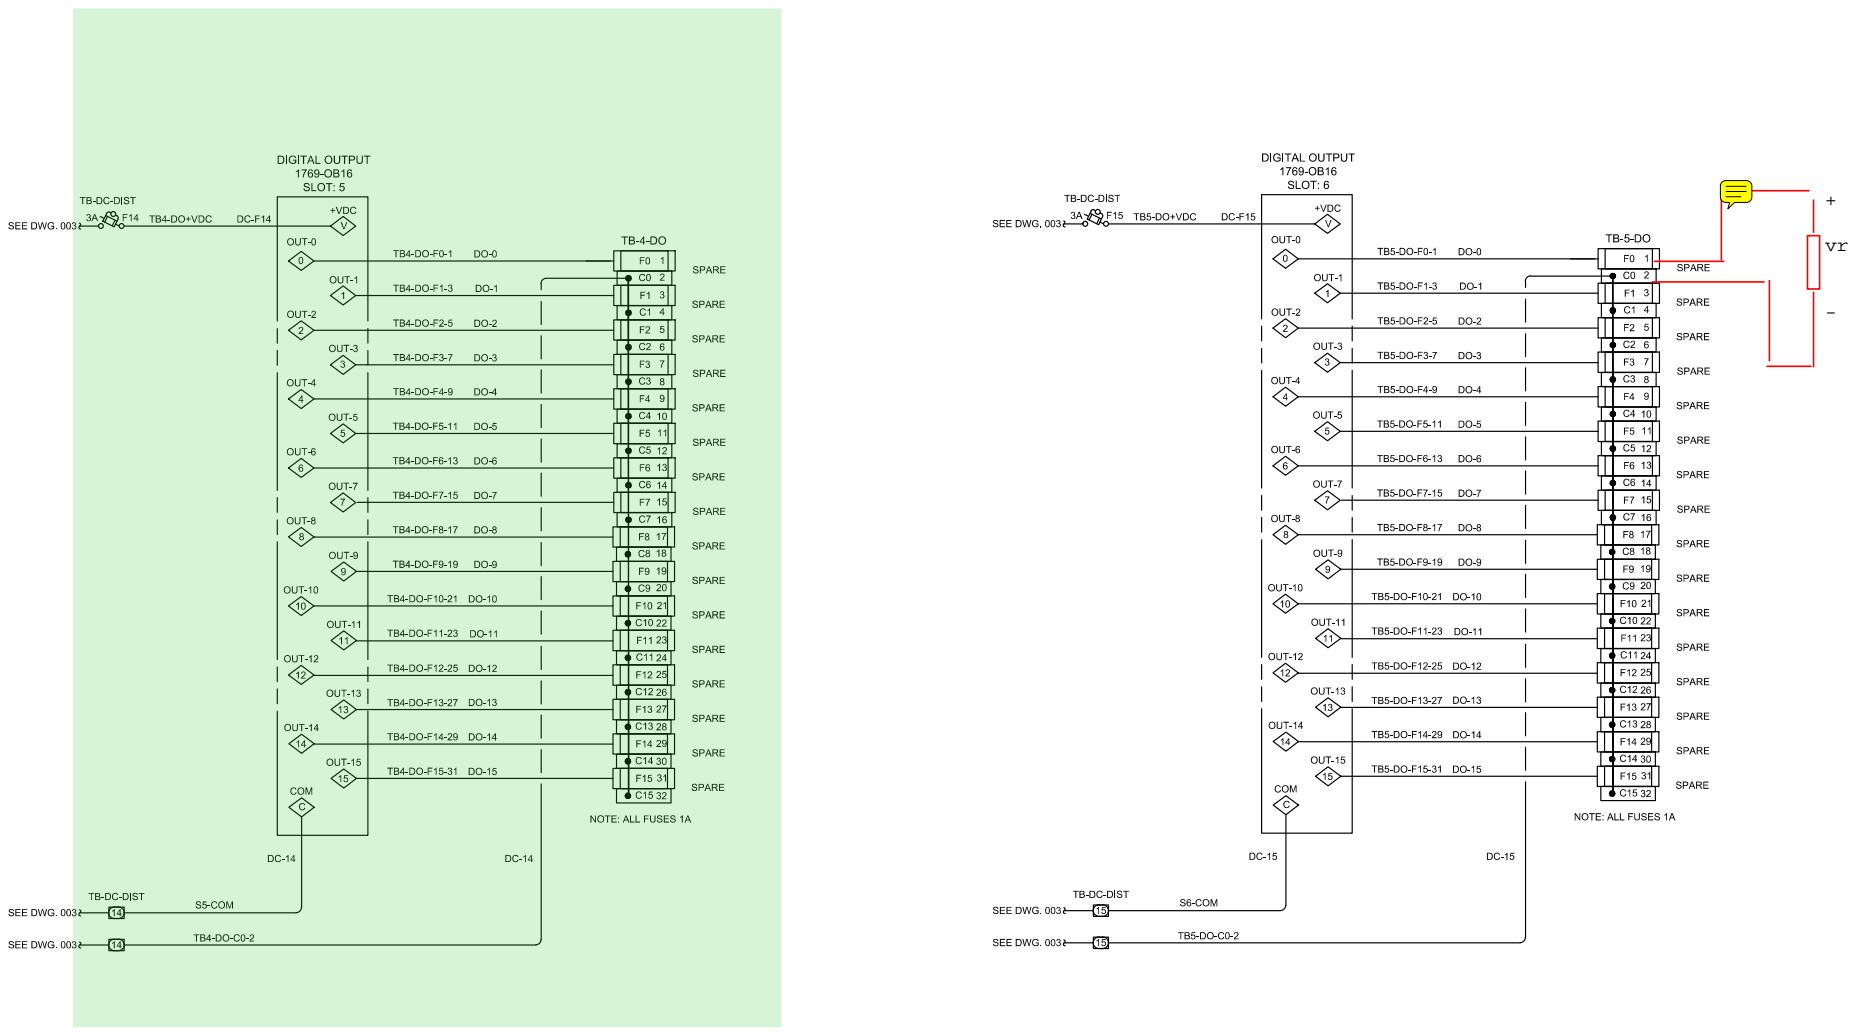
[picture p19: page 7]
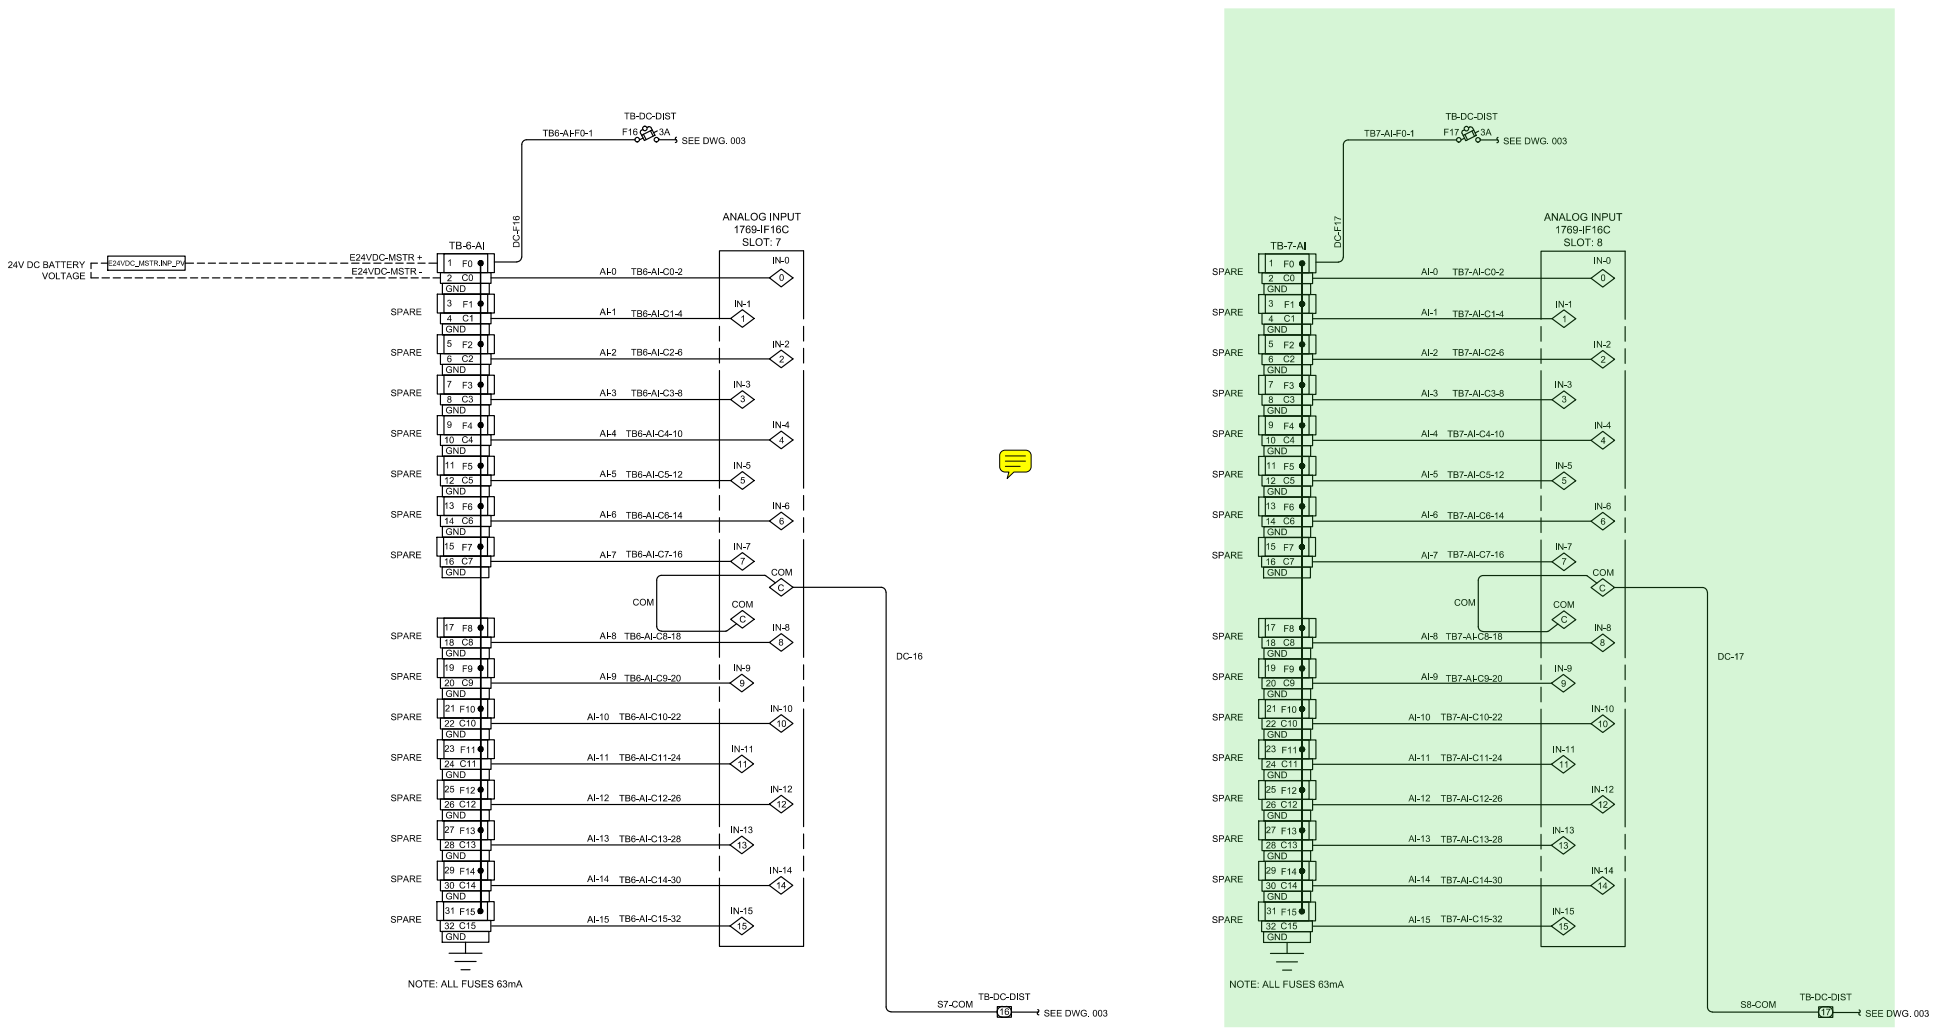
[picture p20: page 8]
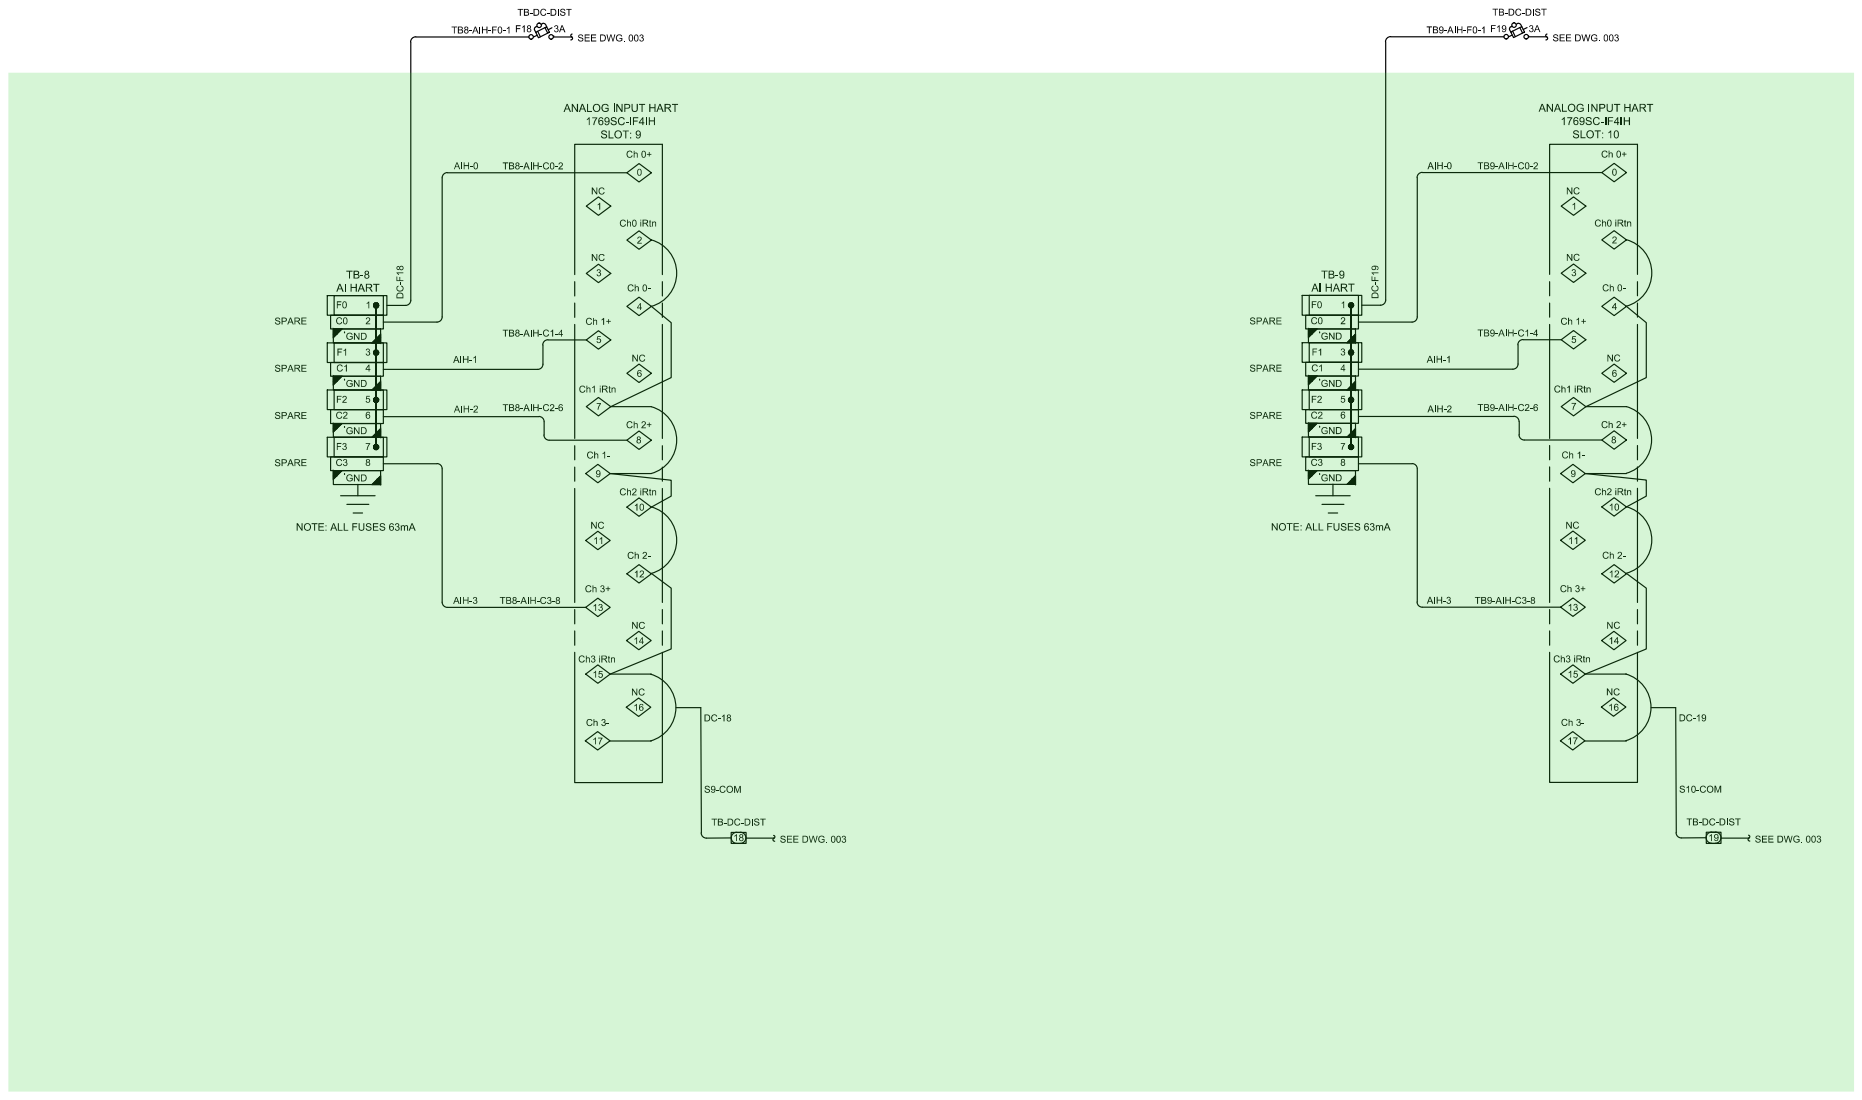
[picture p21: page 9]
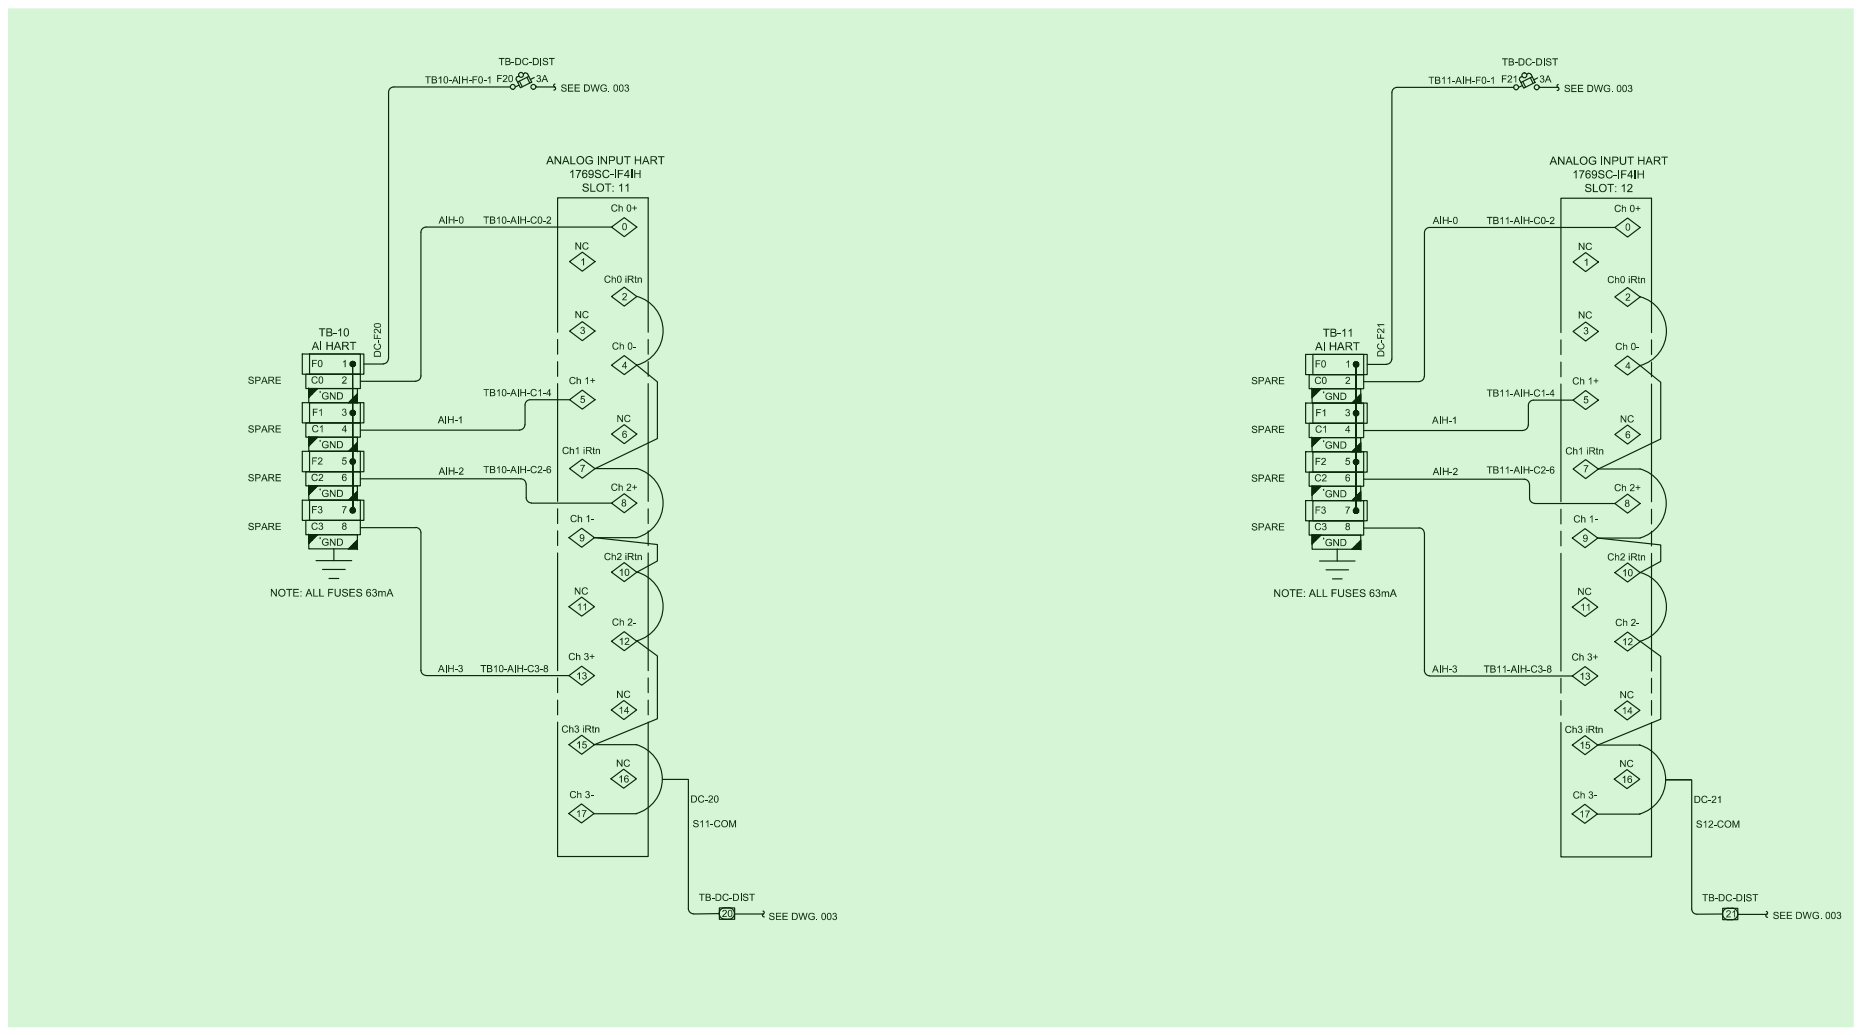
[picture p22: page 10]
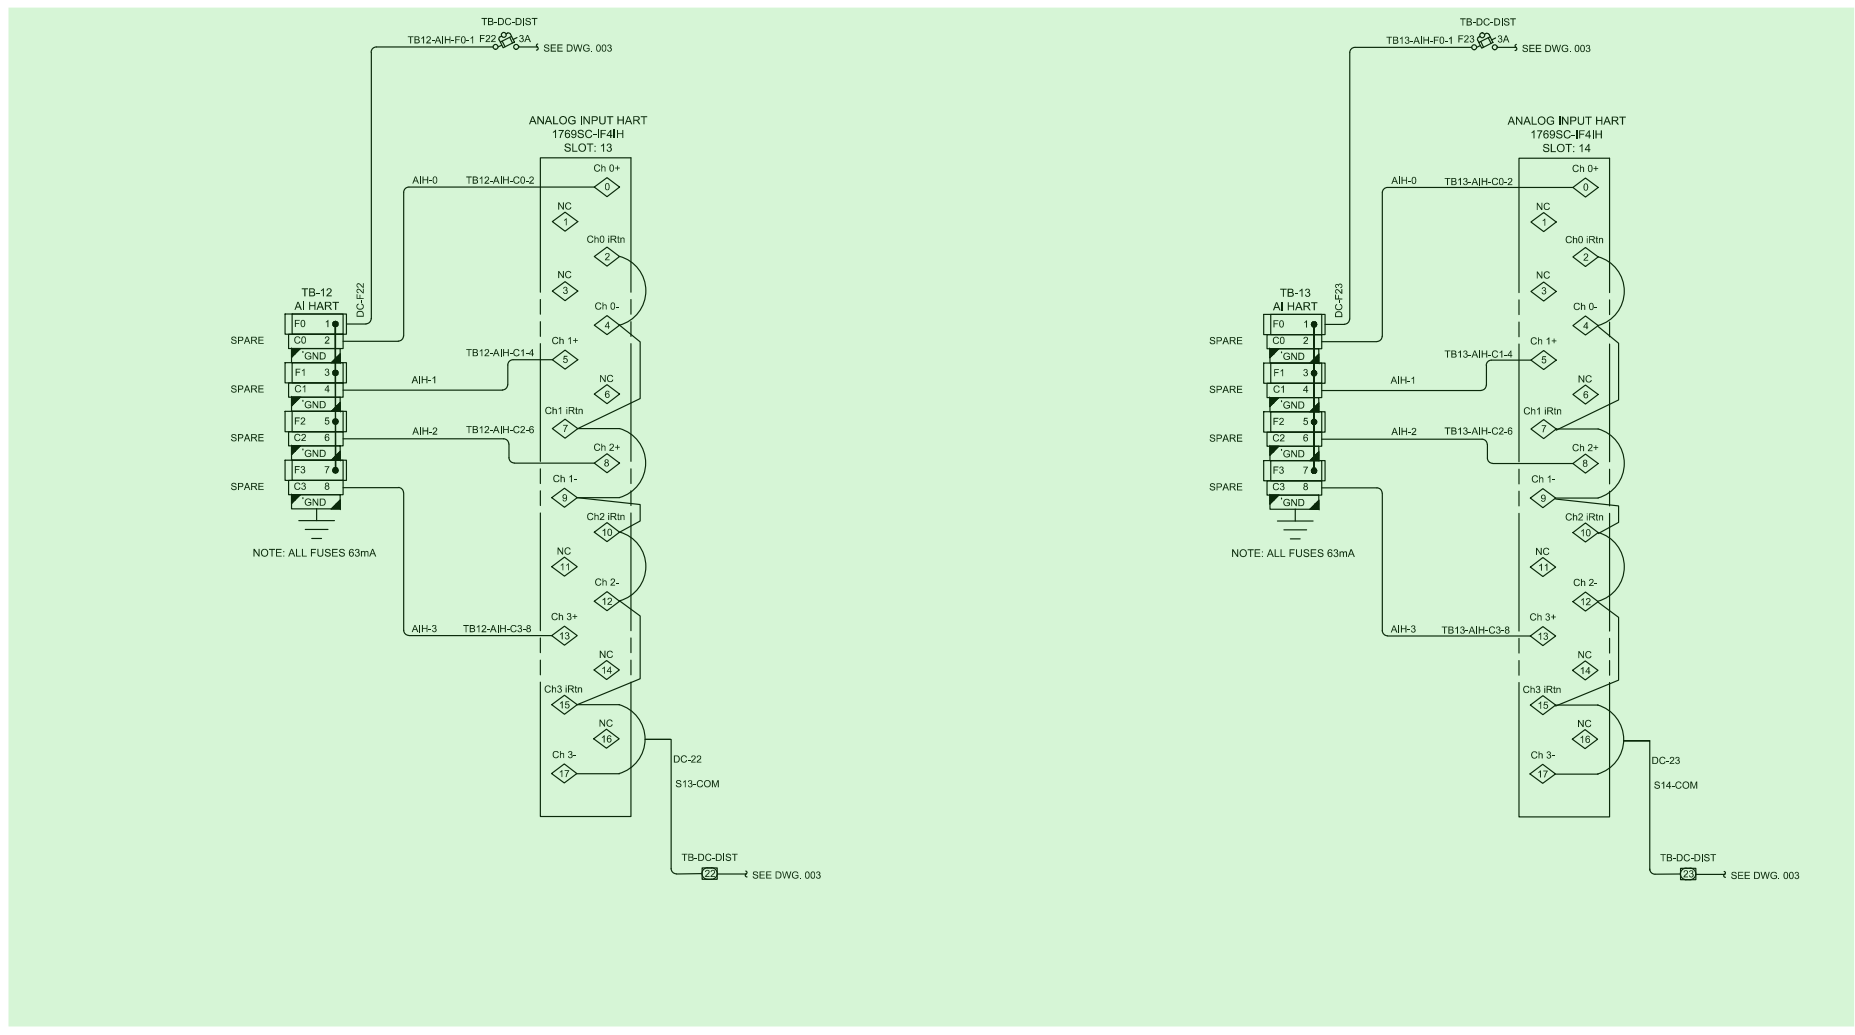
[picture p23: page 11]
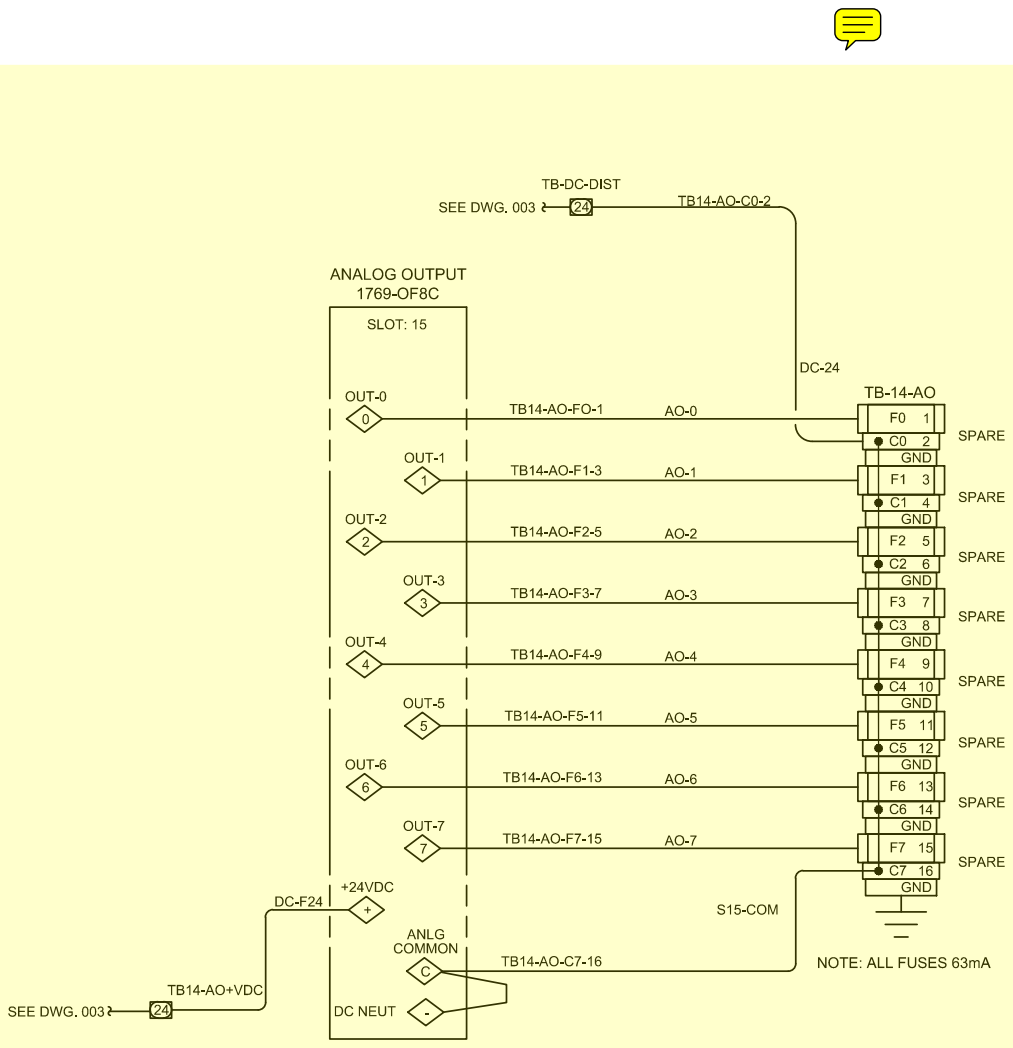
[picture p24: page 12]
