DamianMorales1437/Automatizacion_y_Control/Diseño vru/Planos PDF/AI1-Layout1.pdf

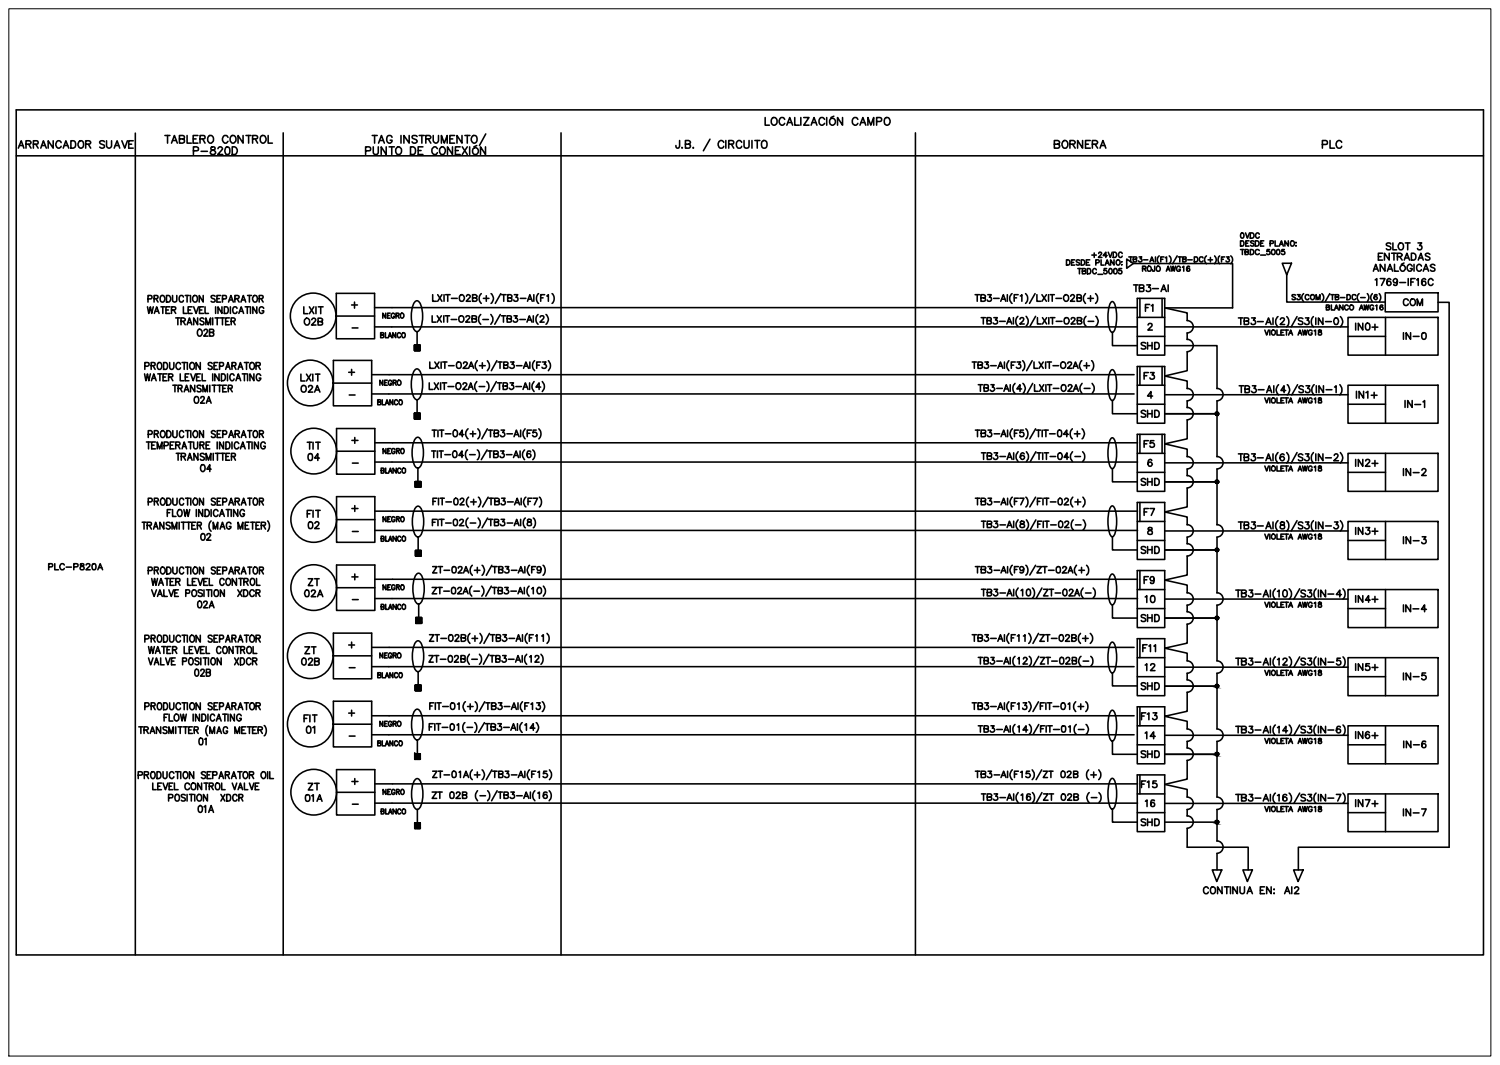
[picture p25: page 1]
