DamianMorales1437/Automatizacion_y_Control/Diseño vru/Planos PDF/AI2-Layout1.pdf

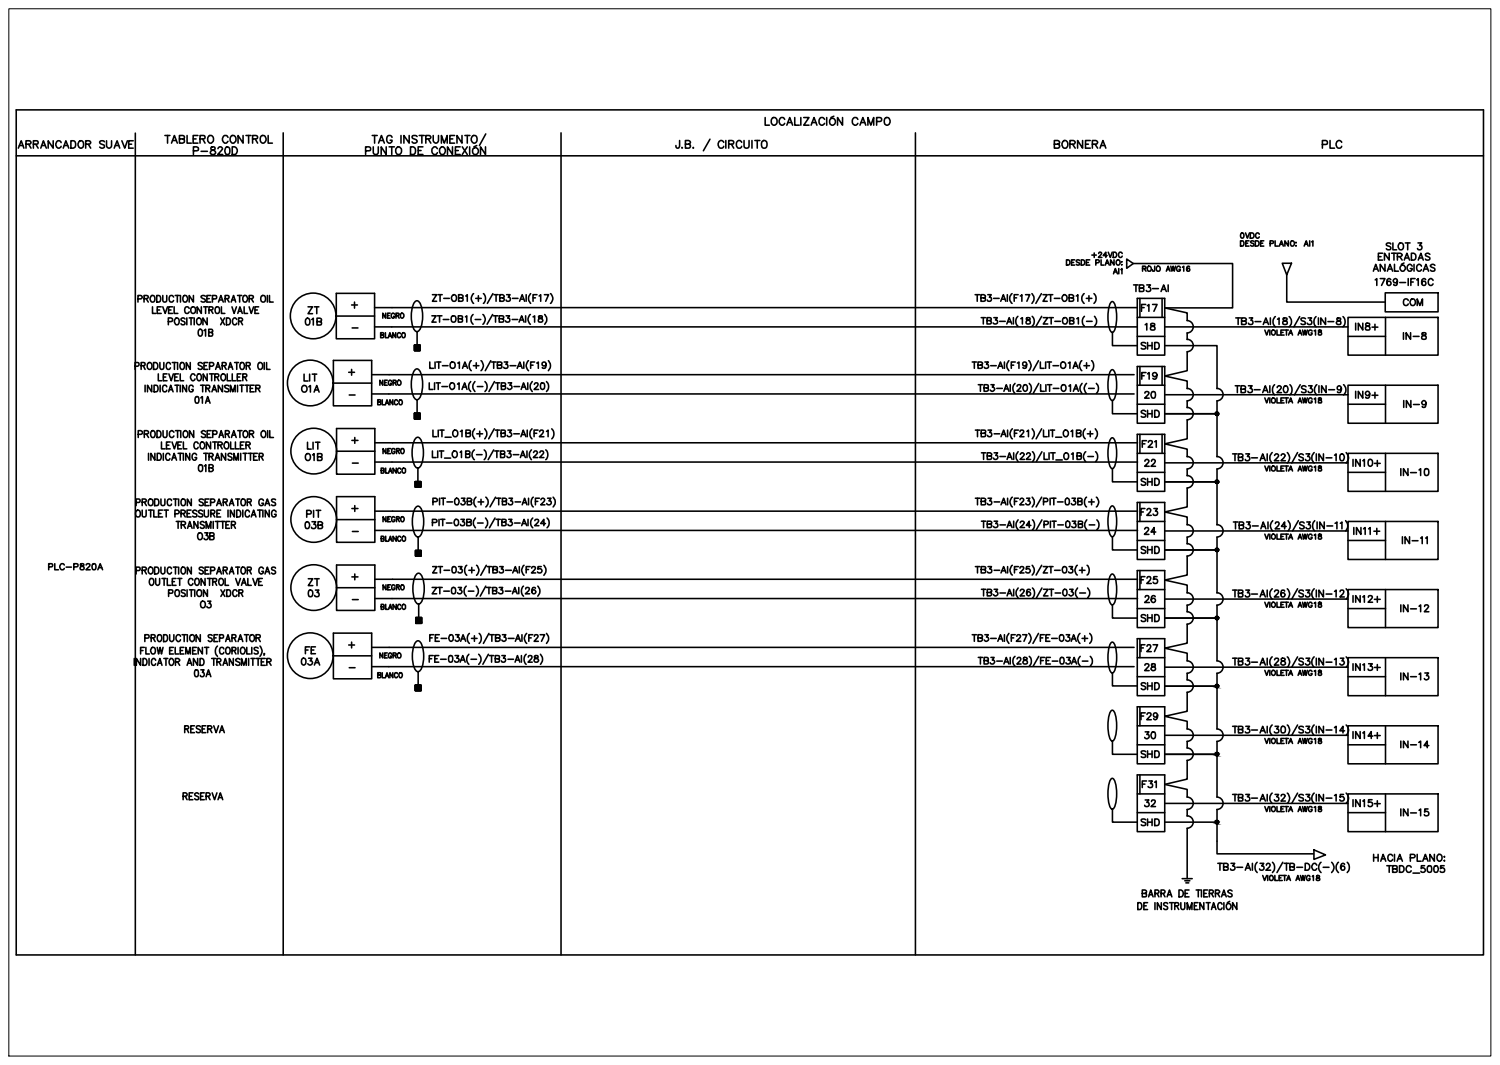
[picture p26: page 1]
