DamianMorales1437/Automatizacion_y_Control/Diseño vru/Planos PDF/Alimentacion120VAC_5004-Layout1.pdf

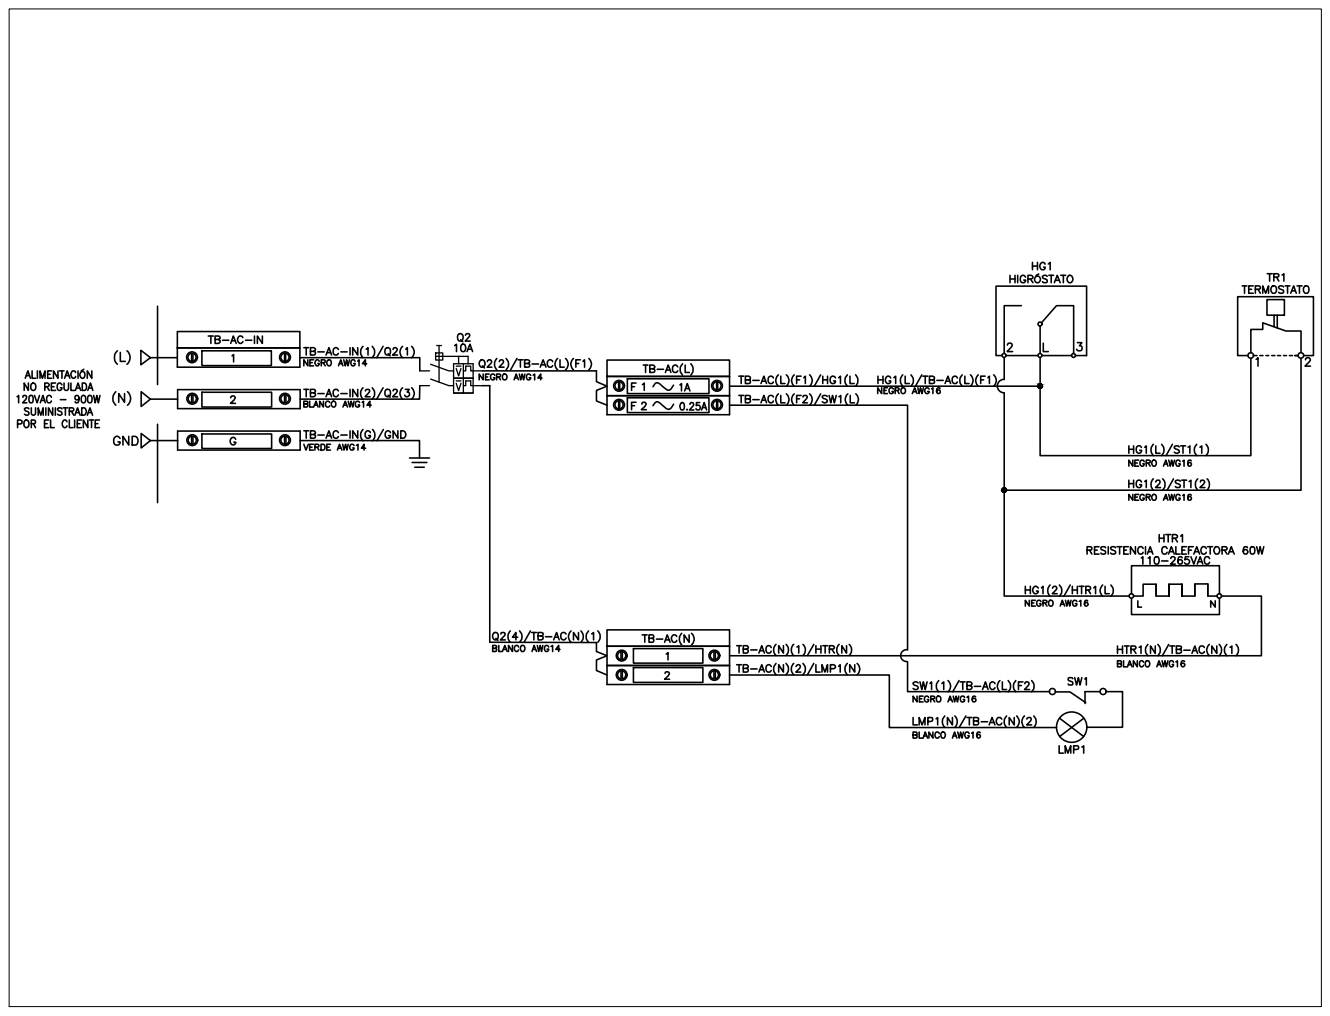
[picture p27: page 1]
