DamianMorales1437/Automatizacion_y_Control/Diseño vru/Planos PDF/Alimentación230VAC_5003-Layout1.pdf

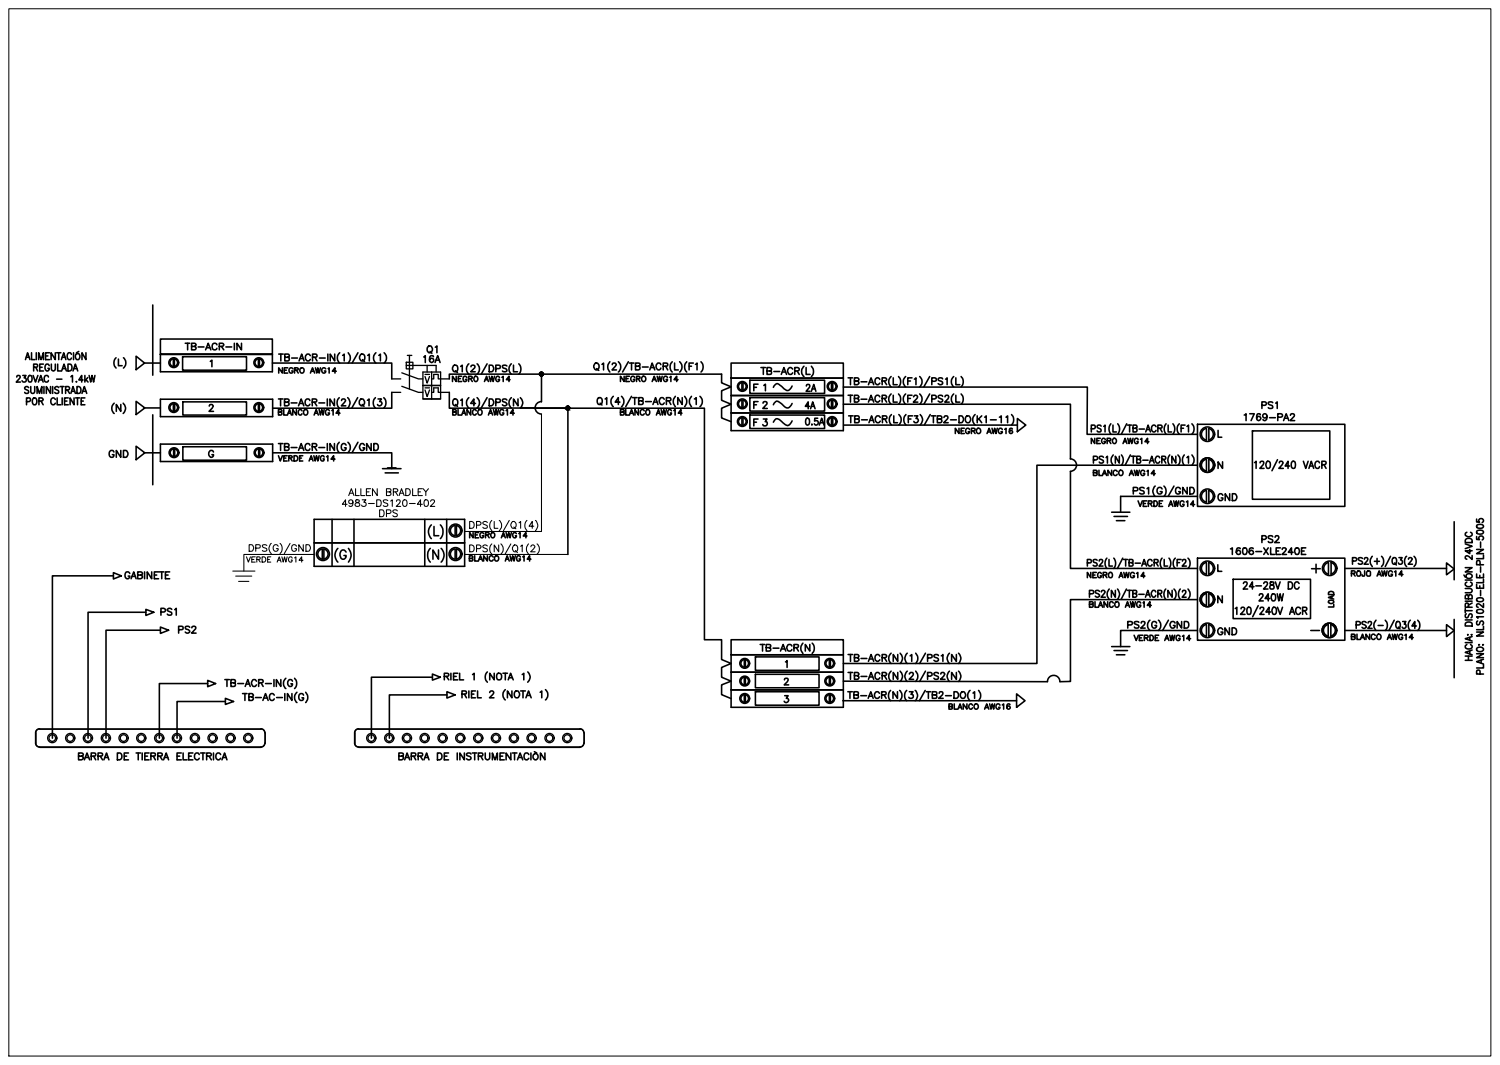
[picture p28: page 1]
