DamianMorales1437/Automatizacion_y_Control/Diseño vru/Planos PDF/AO-Layout1.pdf

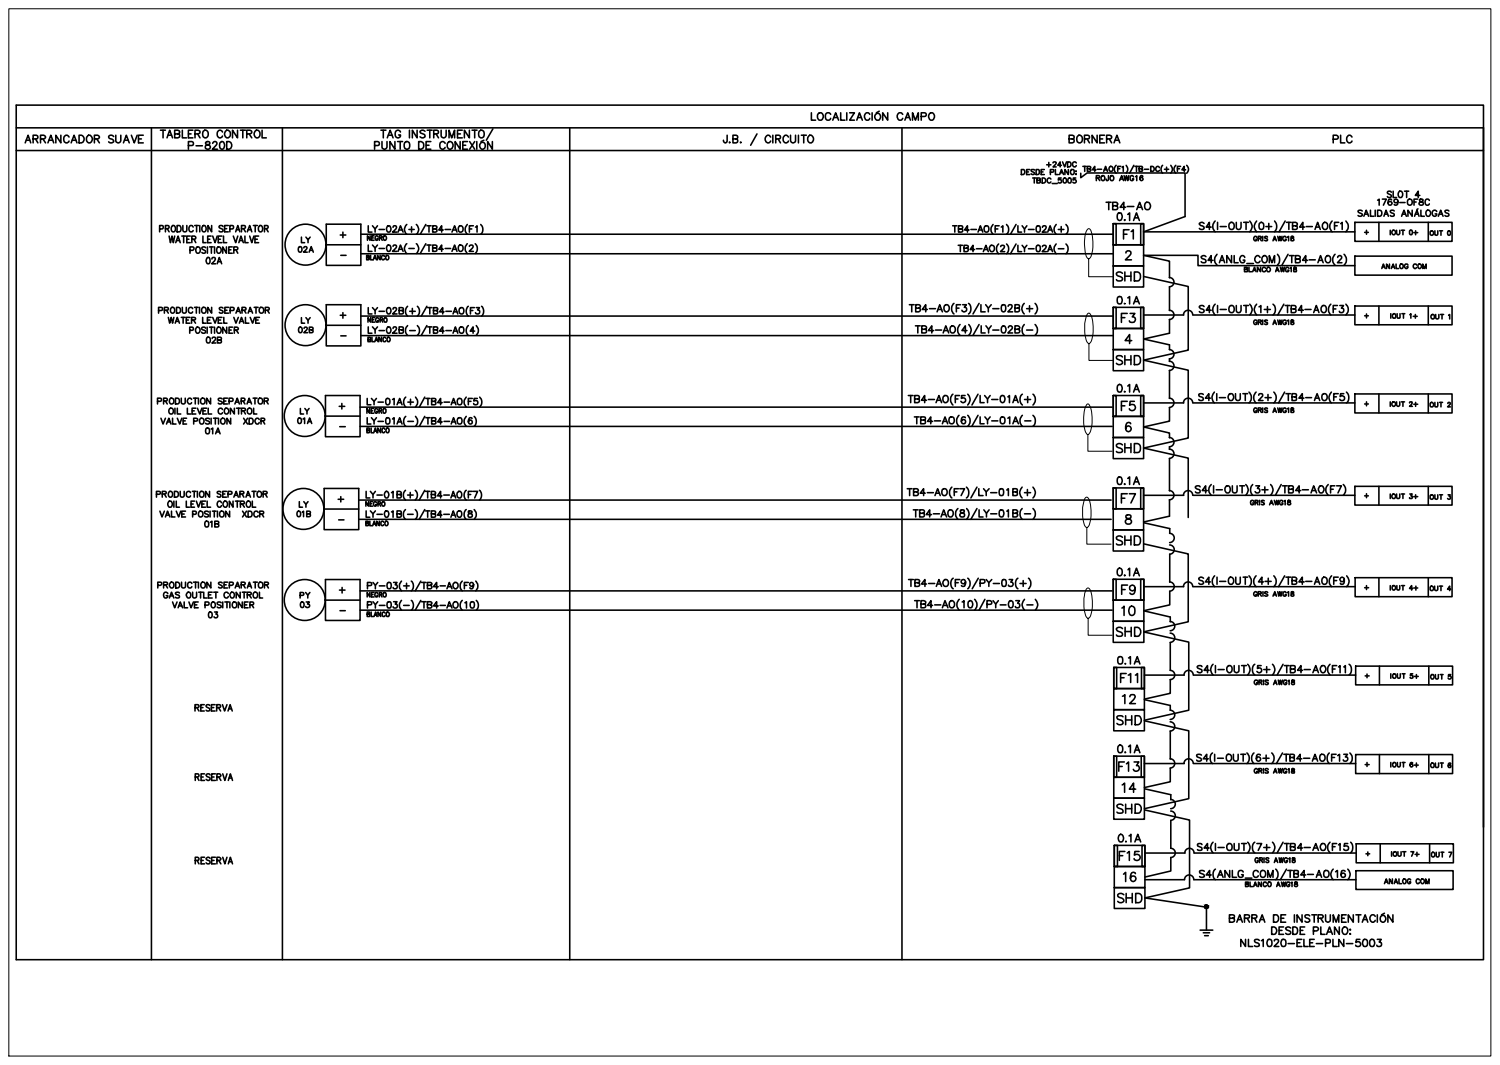
[picture p29: page 1]
