DamianMorales1437/Automatizacion_y_Control/Diseño vru/Planos PDF/DI1-Layout1.pdf

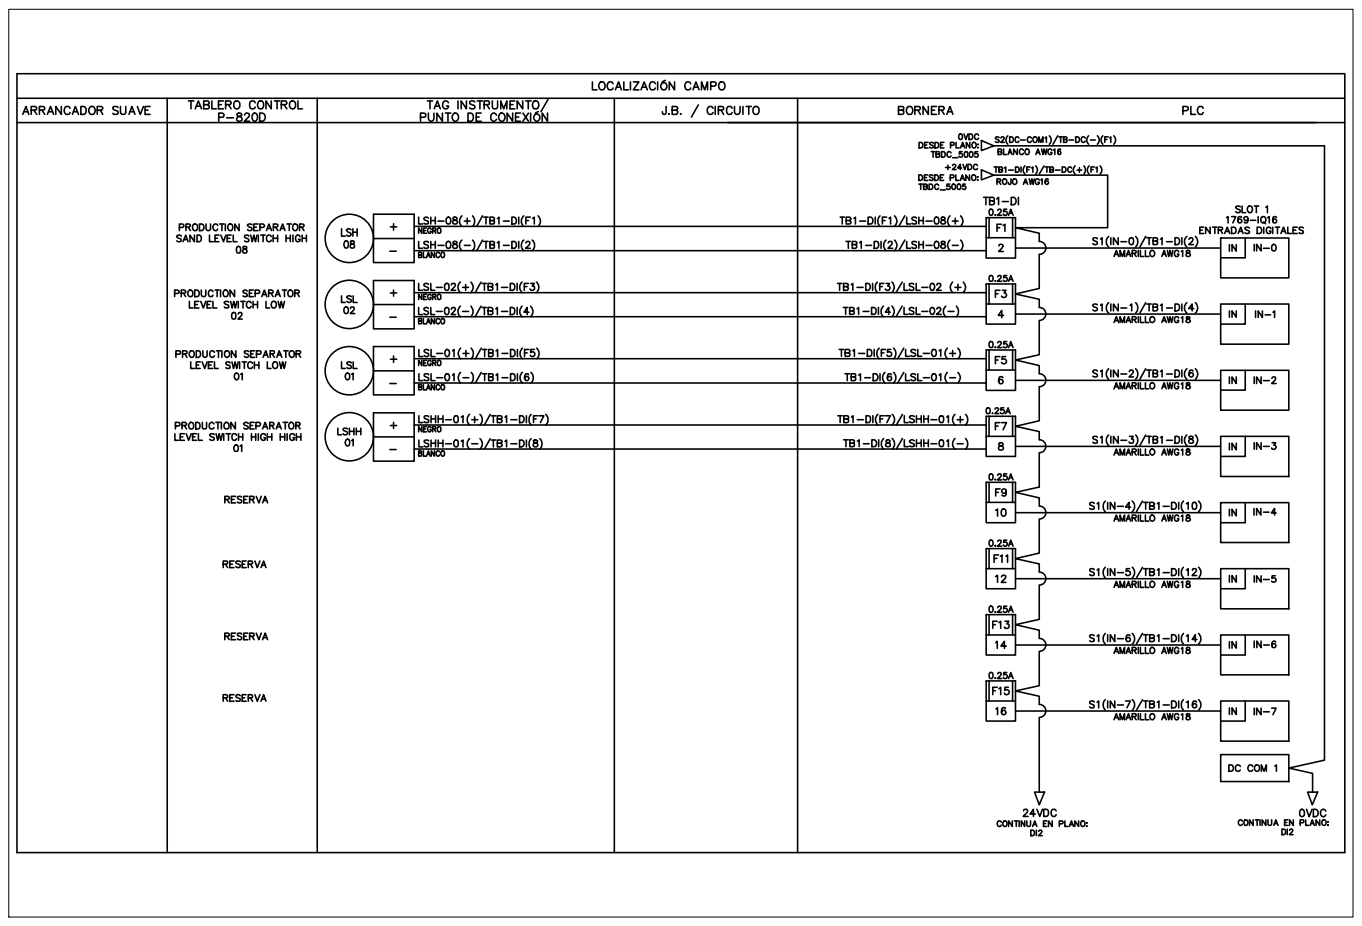
[picture p30: page 1]
