DamianMorales1437/Automatizacion_y_Control/Diseño vru/Planos PDF/DI2-Layout1.pdf

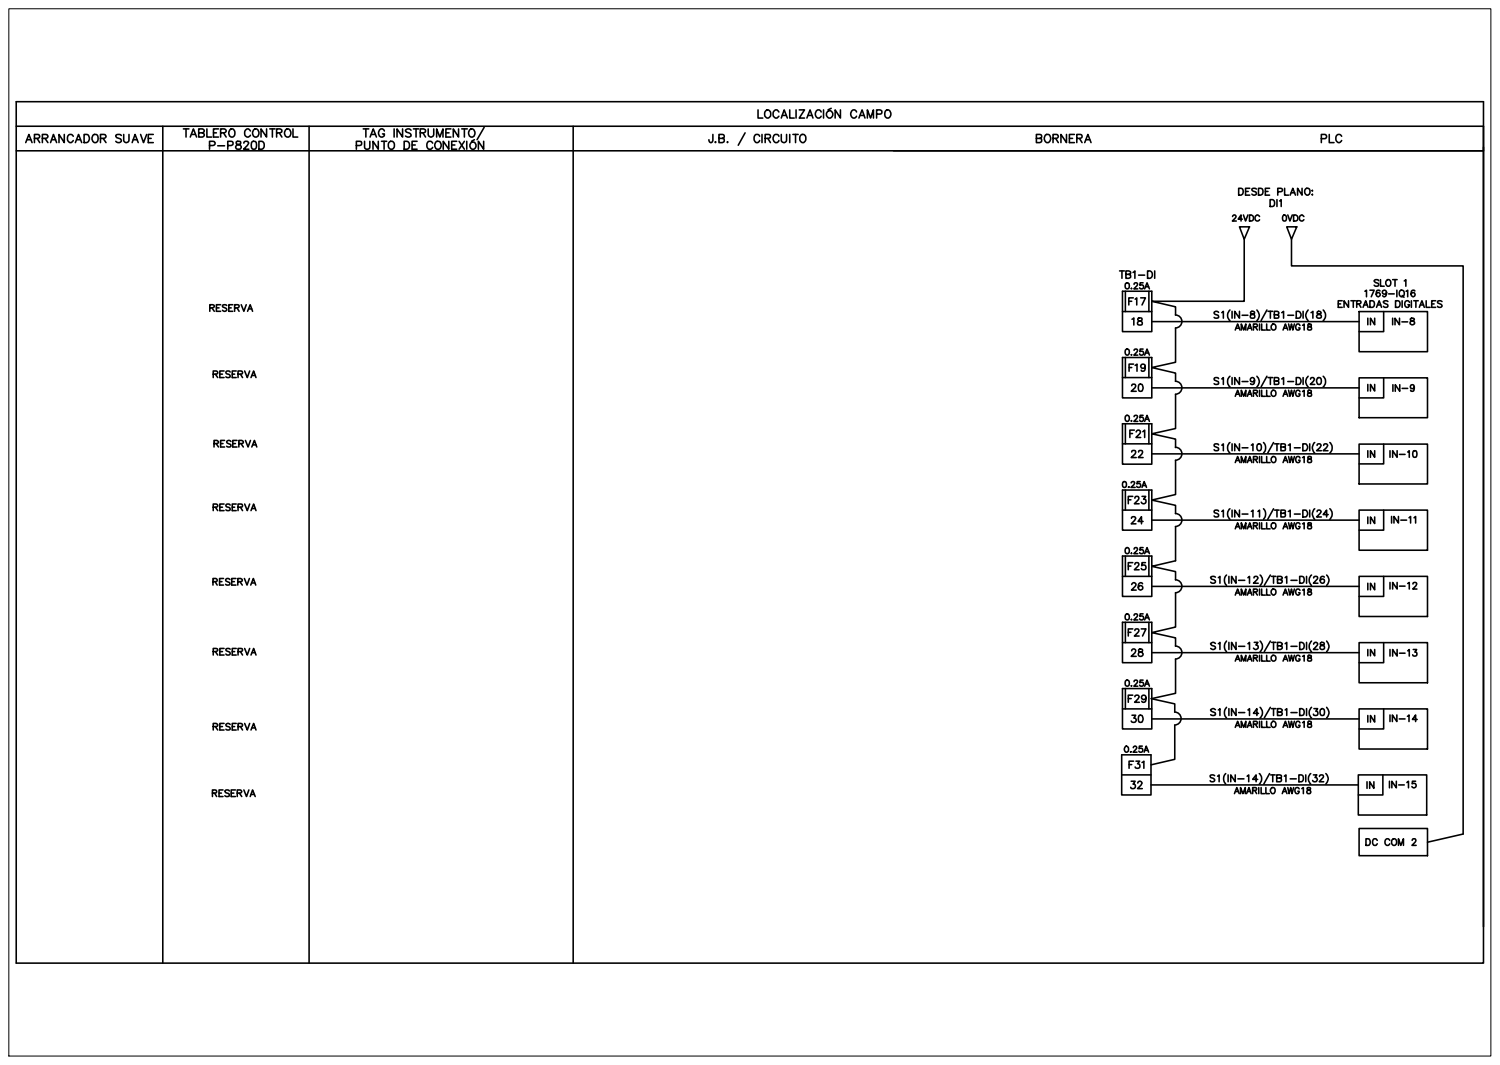
[picture p31: page 1]
