DamianMorales1437/Automatizacion_y_Control/Diseño vru/Planos PDF/DO-Layout1.pdf

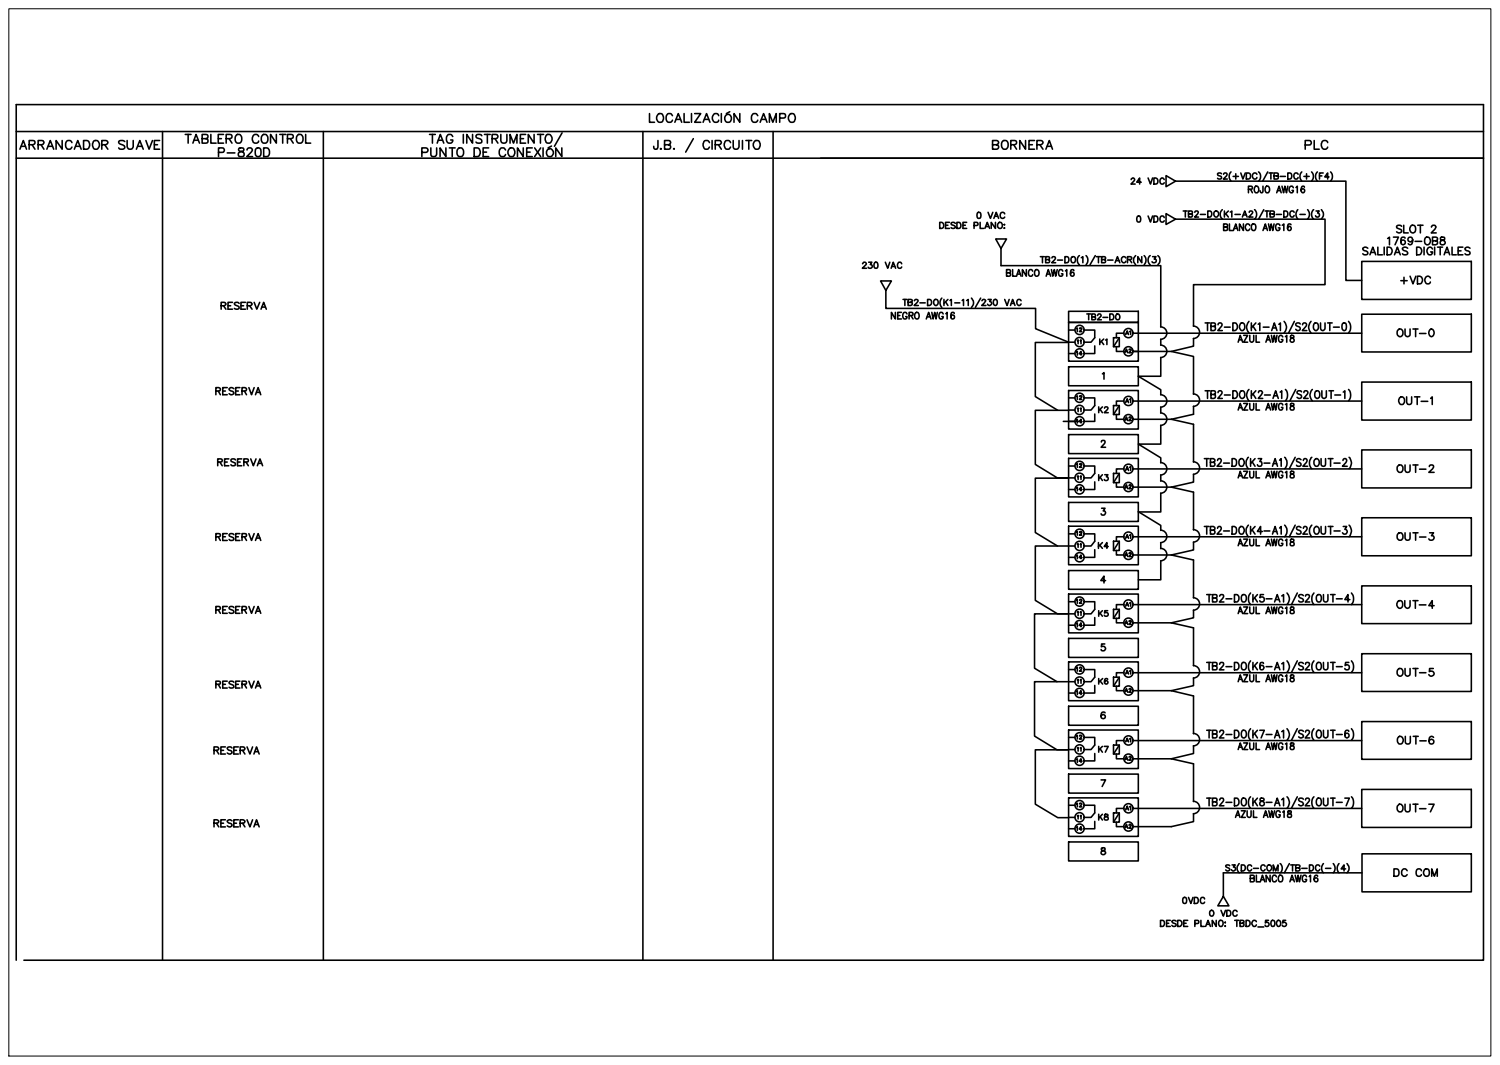
[picture p32: page 1]
