DamianMorales1437/Automatizacion_y_Control/Diseño vru/Planos PDF/TBDC_5005-Layout1.pdf

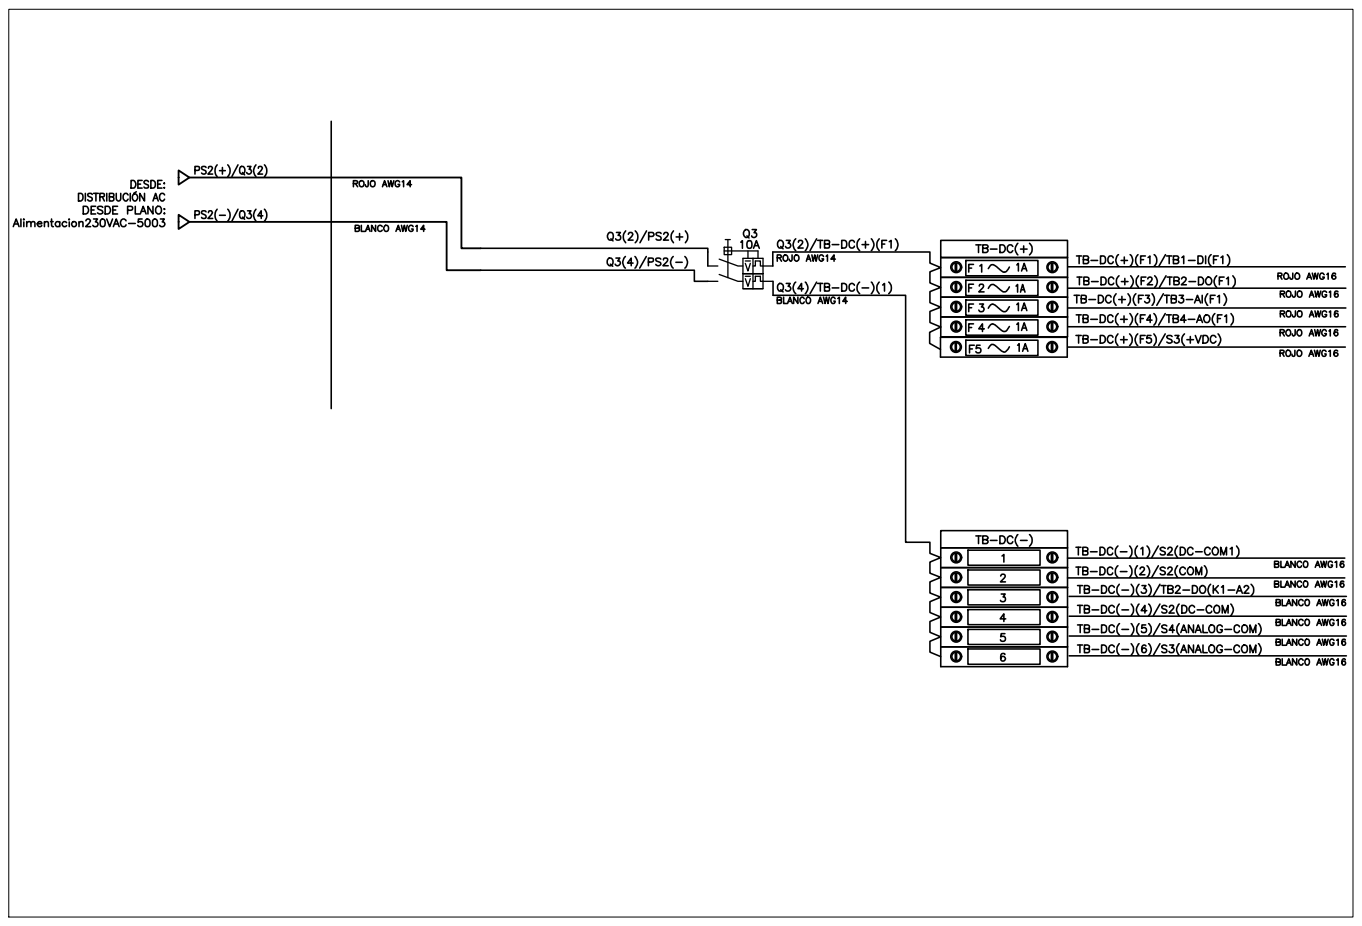
[picture p33: page 1]
