DamianMorales1437/Automatizacion_y_Control/Diseño vru/BBS.pdf

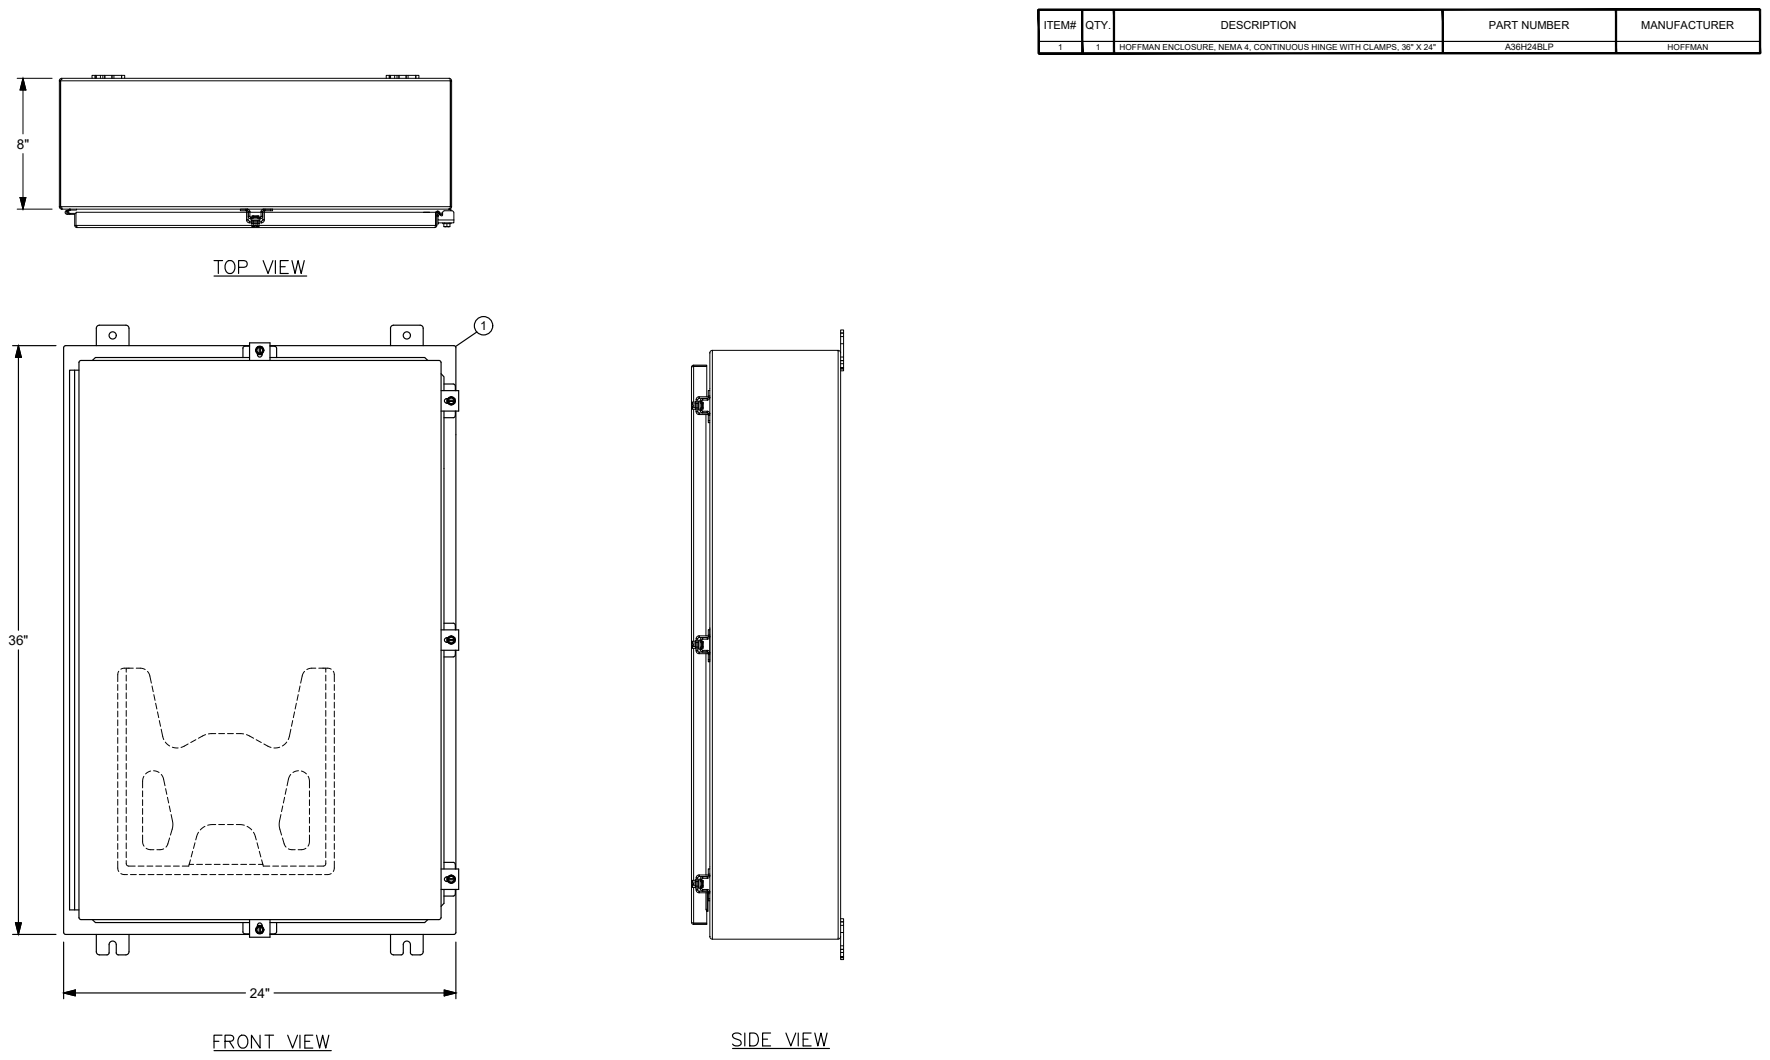
[picture p1: page 1]
ITEM# QTY.; DESCRIPTION; PART NUMBER; MANUFACTURER 1; HOFFMAN ENCLOSURE, NEMA 4, CONTINUOUS HINGE WITH CLAMPS, 36" X 24"; A36H24BLP; HOFFMAN
